Bad-Dog-Designs/Ospray-8/Syntom/Syntom.jpg

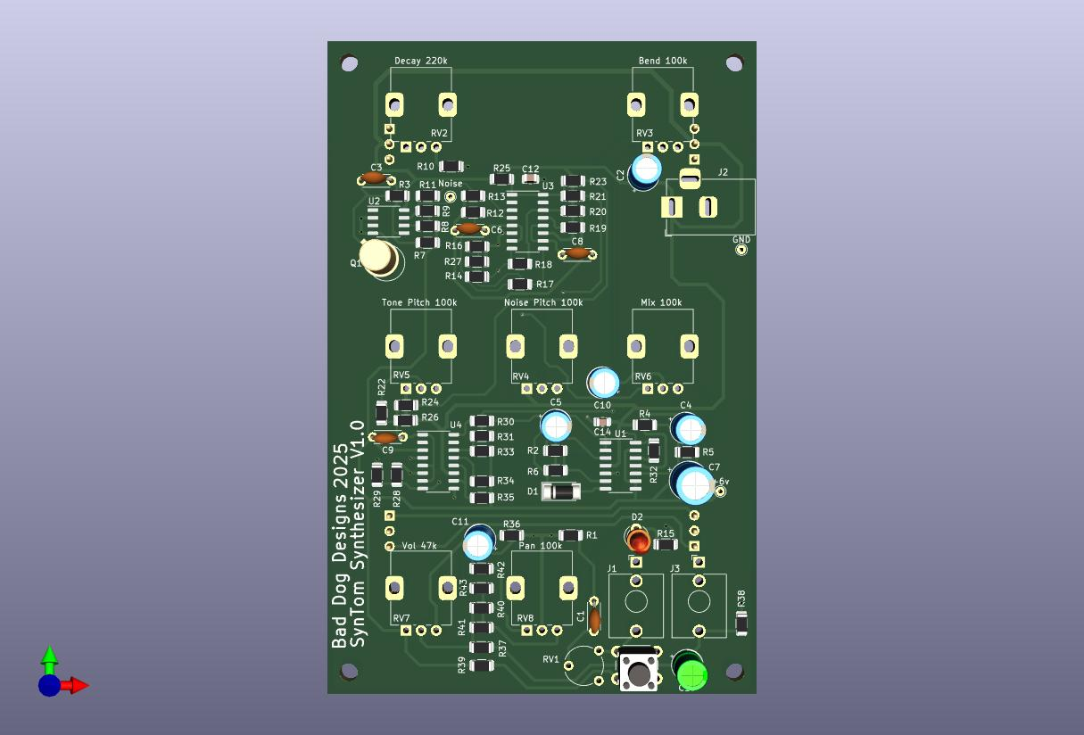
Syntom/Syntom.jpg
