Bad-Dog-Designs/Ospray-8/Front Panel/Side Panel MKII.pdf

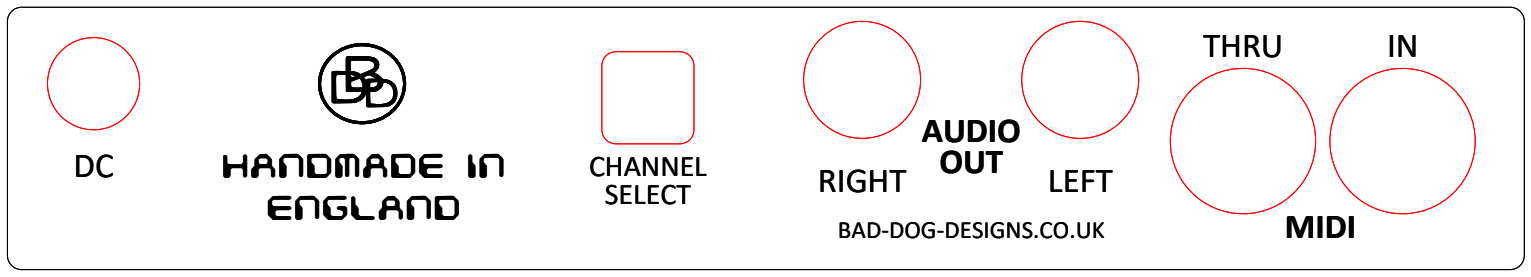
[picture p2: figure]
THRU; RIGHT; LEFT DC; CHANNEL; MIDI; AUDIO; SELECT; OUT; DBD; HANDMADE IN ENGLAND; BAD; -DOG; -DESIGNS.CO.UK
