Bad-Dog-Designs/Ospray-8/Front Panel/Ospray8_Final_front_panel.pdf

## OSPRAY

-8-

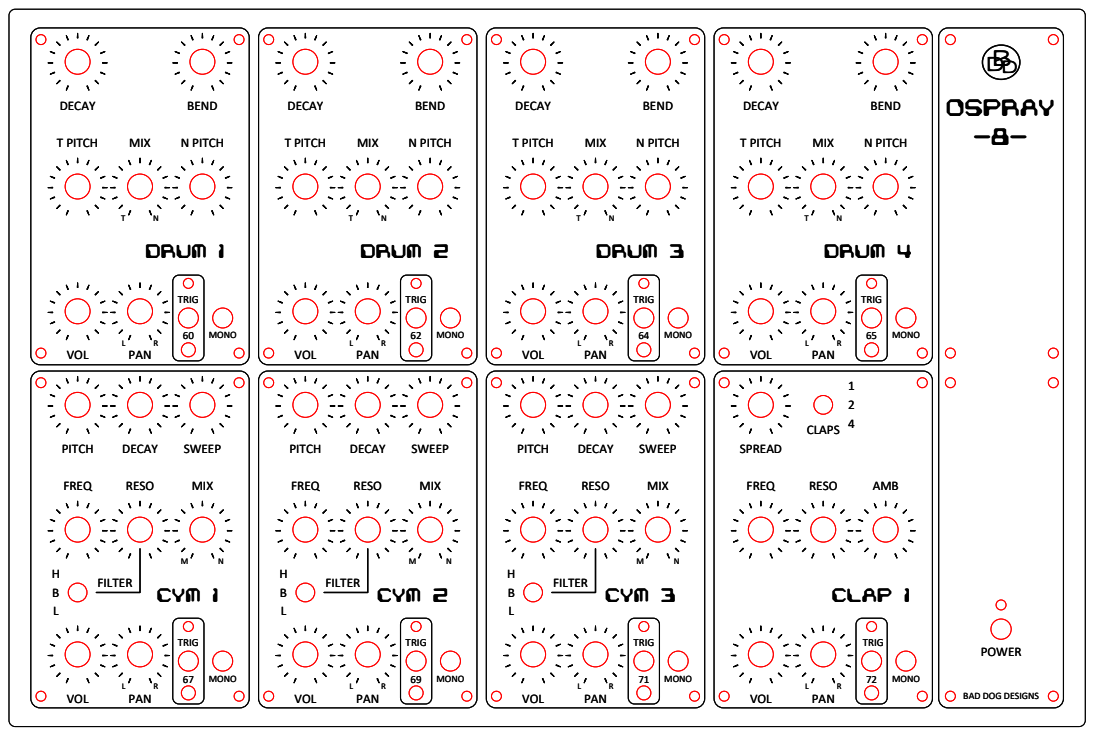
[picture p3: page 1]
PITCH; DECAY; SWEEP; VOL; BEND; FREQ; RESO; PAN; FILTER; T PITCH; MIX; N PITCH; SPREAD; AMB; CLAPS; TRIG; MONO; DRUM 1; DRUM 2; DRUM 3; DRUM 4; CYM 1; CYM 2; CYM 3; CLAP 1; POWER; DBD; OSPRAY -8-

BAD DOG DESIGNS
