Bad-Dog-Designs/Ospray-8/Synbal/Synbal.kicad_pcb

## KiCad design Synbal/Synbal.kicad_pcb (2026-06-27)

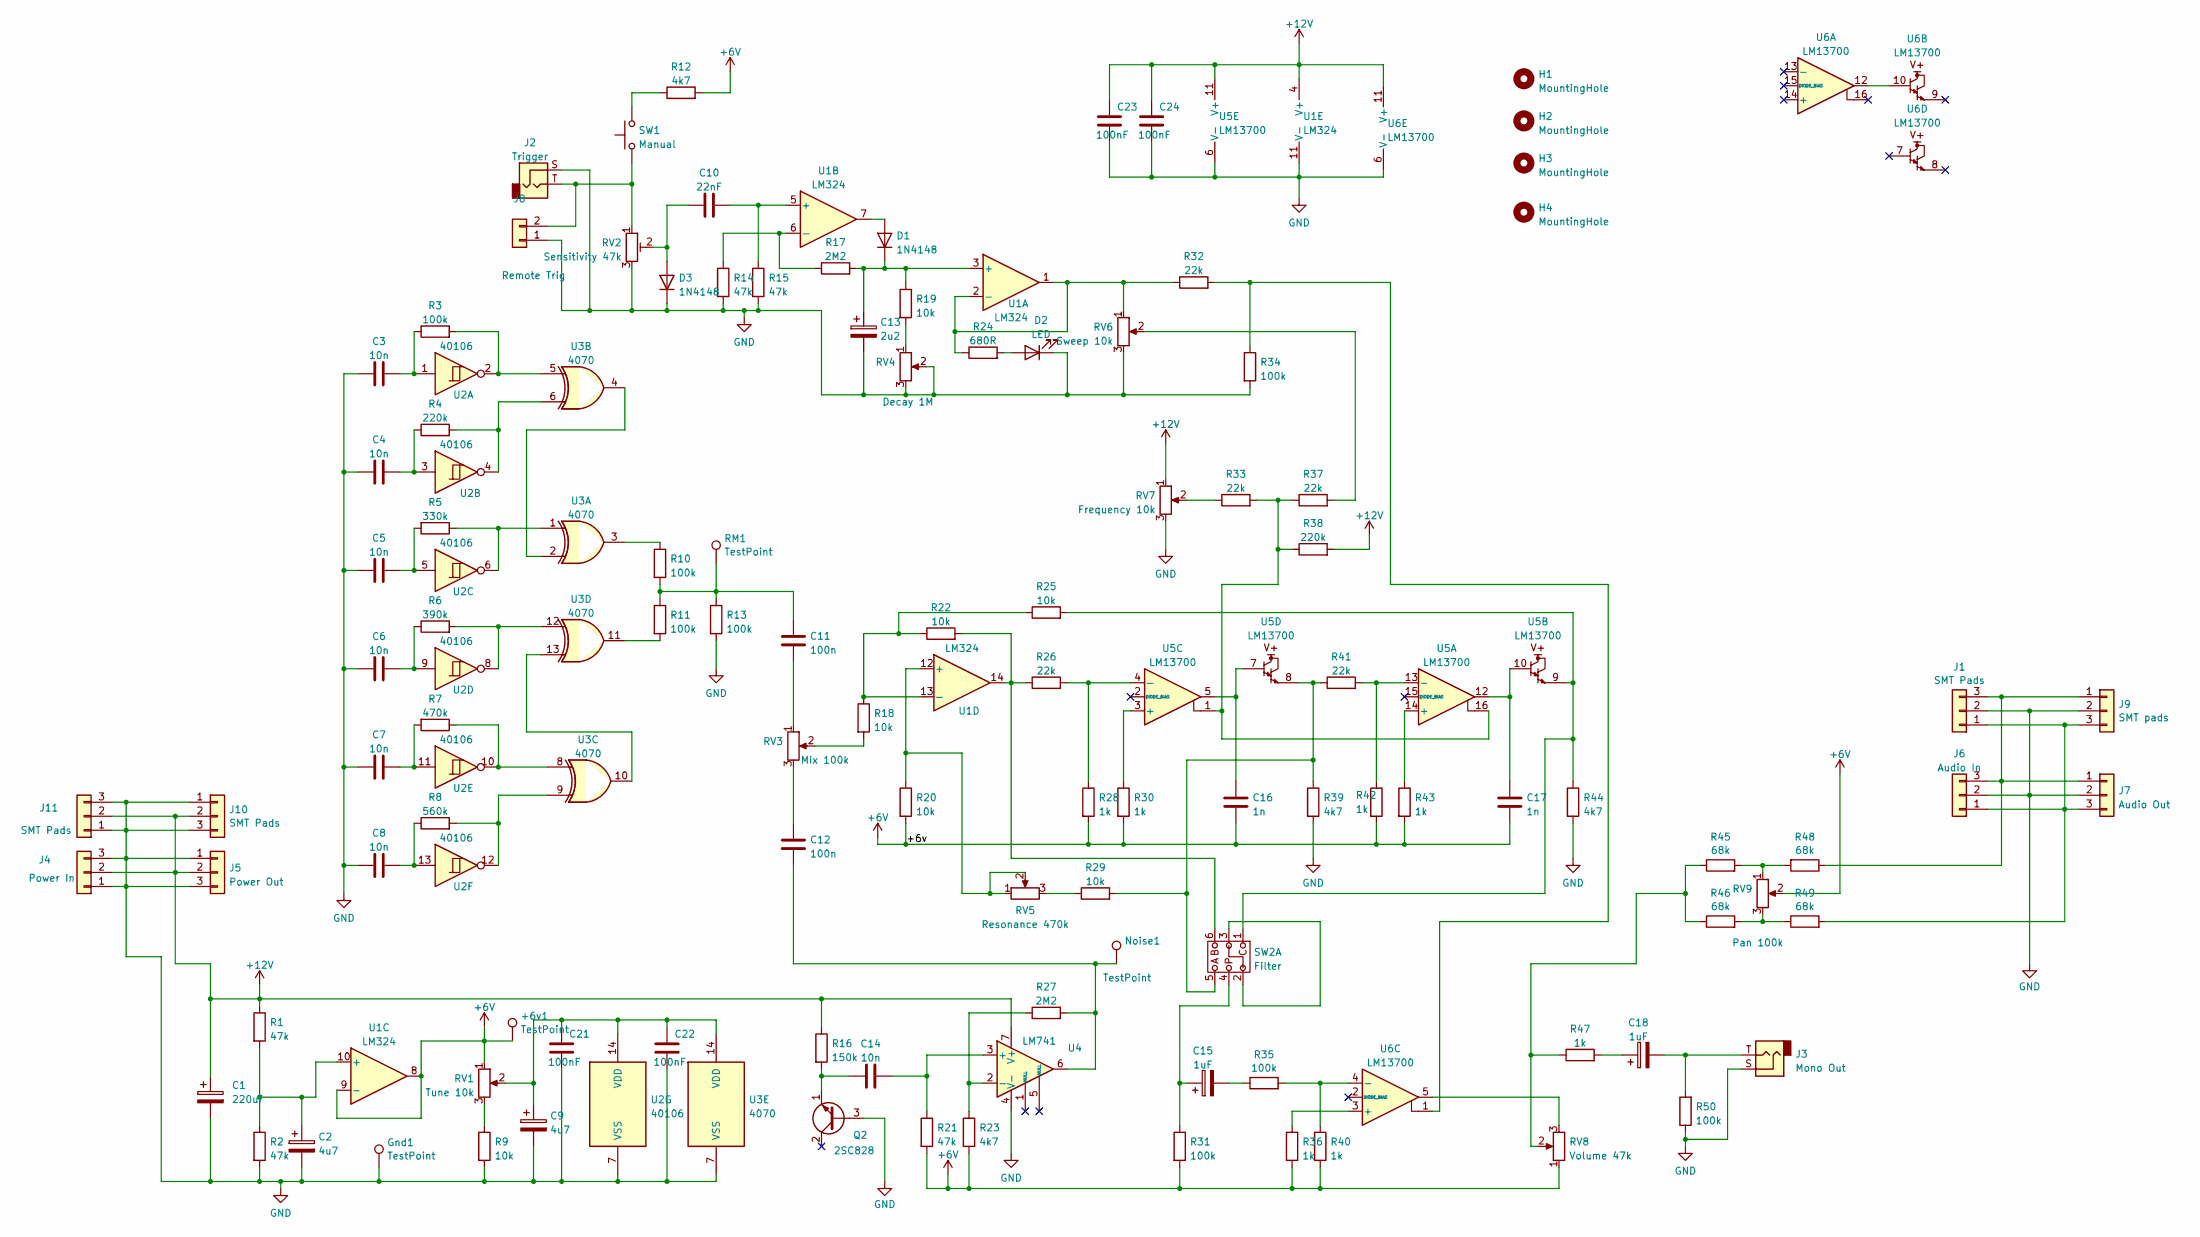
[picture p4: schematic Synbal.kicad_sch]

Parts:
+6v1: TestPoint; TestPoint_Keystone_5010-5014_Multipurpose
C1: 220uf; CP_Radial_D8.0mm_P3.50mm
C2, C9: 4u7; CP_Radial_D4.0mm_P1.50mm
C3, C4, C5, C6, C7, C8, C14: 10n; C_Disc_D7.0mm_W2.5mm_P5.00mm
C10: 22nF; C_Disc_D7.0mm_W2.5mm_P5.00mm
C11, C12: 100n; C_Disc_D7.0mm_W2.5mm_P5.00mm
C13: 2u2; CP_Radial_D4.0mm_P1.50mm
C15, C18: 1uF; CP_Radial_D4.0mm_P1.50mm
C16, C17: 1n; C_Disc_D7.0mm_W2.5mm_P5.00mm
C21, C22, C23, C24: 100nF; C_0805_2012Metric
D1, D3: 1N4148; D_MiniMELF
D2: LED; LED_D3.0mm
Gnd1: TestPoint; TestPoint_Keystone_5010-5014_Multipurpose
H1, H2, H3, H4: MountingHole; MountingHole_3.2mm_M3_ISO7380_Pad
J1, J10, J11: SMT Pads; Bus Connector
J2: Trigger; Jack_3.5mm_QingPu_WQP-PJ398SM_Vertical_CircularHoles
J3: Mono Out; Jack_3.5mm_QingPu_WQP-PJ398SM_Vertical_CircularHoles
J4: Power In; PinHeader_1x03_P2.54mm_Horizontal
J5: Power Out; PinHeader_1x03_P2.54mm_Horizontal
J6: Audio In; PinHeader_1x03_P2.54mm_Horizontal
J7: Audio Out; PinHeader_1x03_P2.54mm_Horizontal
J8: Remote Trig; PinHeader_1x02_P2.54mm_Vertical
J9: SMT pads; Bus Connector
Noise1: TestPoint; TestPoint_Keystone_5010-5014_Multipurpose
Q2: 2SC828; TO-92_Inline
R1, R2, R14, R15, R21: 47k; R_1206_3216Metric
R3, R10, R11, R13, R31, R34, R35, R50: 100k; R_1206_3216Metric
R4, R38: 220k; R_1206_3216Metric
R5: 330k; R_1206_3216Metric
R6: 390k; R_1206_3216Metric
R7: 470k; R_1206_3216Metric
R8: 560k; R_1206_3216Metric
R9, R18, R19, R20, R22, R25, R29: 10k; R_1206_3216Metric
R12, R23, R39, R44: 4k7; R_1206_3216Metric
R16: 150k; R_1206_3216Metric
R17, R27: 2M2; R_1206_3216Metric
R24: 680R; R_1206_3216Metric
R26, R32, R33, R37, R41: 22k; R_1206_3216Metric
R28, R30, R36, R40, R42, R43, R47: 1k; R_1206_3216Metric
R45, R46, R48, R49: 68k; R_1206_3216Metric
RM1: TestPoint; TestPoint_Keystone_5010-5014_Multipurpose
RV1: Tune 10k; Potentiometer_Alps_RK09K_Single_Vertical
RV2: Sensitivity 47k; Potentiometer_Piher_PT-6-V_Vertical
RV3: Mix 100k; Potentiometer_Alps_RK09K_Single_Vertical
RV4: Decay 1M; Potentiometer_Alps_RK09K_Single_Vertical
RV5: Resonance 470k; Potentiometer_Alps_RK09K_Single_Vertical
RV6: Sweep 10k; Potentiometer_Alps_RK09K_Single_Vertical
RV7: Frequency 10k; Potentiometer_Alps_RK09K_Single_Vertical
RV8: Volume 47k; Potentiometer_Alps_RK09K_Single_Vertical
RV9: Pan 100k; Potentiometer_Alps_RK09K_Single_Vertical
SW1: Manual; SW_PUSH_6mm_H5mm
SW2: Filter; 1P3WSW
U1: LM324; SOIC-14_3.9x8.7mm_P1.27mm
U2: 40106; SO-14_3.9x8.65mm_P1.27mm
U3: 4070; SO-14_3.9x8.65mm_P1.27mm
U4: LM741; SOIC-8_3.9x4.9mm_P1.27mm
U5, U6: LM13700; SOIC-16_3.9x9.9mm_P1.27mm

Connections:
+6V: +6v1.1, C16.2, C17.2, R12.2, R20.2, R21.2, R23.2, R28.2, R30.2, R31.2, R36.2, R40.2, R42.2, R43.2, RV1.1, RV8.1, RV9.2, U1.8, U1.9 (-); also elsewhere on the board
+12V: C1.1, C23.1, C24.1, J4.2, J5.2, J10.2, J11.2, R1.1, R16.1, R38.2, RV7.1, U1.4 (V+), U4.7 (V+), U5.11 (V+), U6.11 (V+)
GND: C1.2, C2.2, C3.1, C4.1, C5.1, C6.1, C7.1, C8.1, C9.2, C13.2, C21.2, C22.2, C23.2, C24.2, D2.1 (K), D3.1 (K), Gnd1.1, H1.1, H2.1, H3.1, H4.1, J1.2, J2.S, J3.S, J4.1, J4.3, J5.1, J5.3, J6.2, J7.2, J8.1, J9.2, J10.1, J10.3, J11.1, J11.3, Q2.3 (B), R2.2, R9.2, R13.2, R14.2, R15.2, R34.2, R39.2, R44.2, R50.1, RV1.MP, RV2.3, RV3.MP, RV4.2, RV4.3, RV4.MP, RV5.MP, RV6.3, RV6.MP, RV7.3, RV7.MP, RV8.MP, RV9.MP, U1.11 (V-), U2.7 (VSS), U3.7 (VSS), U4.4 (V-), U5.6 (V-), U6.6 (V-); also elsewhere on the board
unnamed: C3.2, R3.1, U2.1
unnamed: C4.2, R4.1, U2.3
unnamed: C5.2, R5.2, U2.5
unnamed: C6.2, R6.1, U2.9
unnamed: C7.2, R7.2, U2.11
unnamed: C8.2, R8.1, U2.13
unnamed 9: C11.1, R10.2, R11.1, R13.1, RM1.1; also elsewhere on the board
unnamed: C11.2, RV3.1
unnamed: C12.1, RV3.3
unnamed 12: C12.2, Noise1.1, R27.2, U4.6; also elsewhere on the board
unnamed: C15.1, R31.1, SW2.4
unnamed: C15.2, R35.1
unnamed: C16.1, U5.5, U5.7
unnamed: C17.1, U5.10, U5.12
unnamed: C18.1, R47.2
unnamed: C18.2, J3.T, R50.2
unnamed: D1.2 (A), U1.7
unnamed: C13.1, D1.1 (K), R17.2, R19.1, U1.3 (+)
unnamed: D2.2 (A), R24.2
unnamed: C10.1, D3.2 (A), RV2.2
unnamed: J1.1, J6.1, J7.3, J9.3, R49.2
unnamed: J1.3, J6.3, J7.1, J9.1, R48.1
unnamed: J2.T, J8.2, RV2.1, SW1.1
unnamed: C14.1, Q2.1 (E), R16.2
unnamed: R3.2, U2.2, U3.5
unnamed: R4.2, U2.4, U3.6
unnamed: R5.1, U2.6, U3.1
unnamed: R6.2, U2.8, U3.12
unnamed: R7.1, U2.10, U3.8
unnamed: R8.2, U2.12, U3.9
unnamed: R9.1, RV1.3
unnamed: R10.1, U3.3
unnamed: R11.2, U3.11
unnamed: R12.1, SW1.2
unnamed: R18.2, RV3.2
unnamed: R19.2, RV4.1
unnamed: R22.2, R26.1, SW2.6, U1.14
unnamed: R25.2, R44.1, SW2.1, U5.9
unnamed: R29.1, RV5.3
unnamed: R29.2, R39.1, R41.1, SW2.5, U5.8
unnamed: R32.2, R34.1, U6.1
unnamed: R33.1, RV7.2
unnamed: R33.2, R37.1, R38.1, U5.1, U5.16
unnamed: R37.2, RV6.2
unnamed: R45.1, R46.1, R47.1, RV8.2
unnamed: R45.2, R48.2, RV9.1
unnamed: R46.2, R49.1, RV9.3
unnamed: RV8.3, U6.5
unnamed: SW2.2, SW2.3
unnamed: R24.1, R32.1, RV6.1, U1.1, U1.2 (-)
unnamed: C10.2, R15.1, U1.5 (+)
unnamed: R14.1, R17.1, U1.6 (-)
unnamed: C2.1, R1.2, R2.1, U1.10 (+)
unnamed: R20.1, RV5.1, RV5.2, U1.12 (+)
unnamed: R18.1, R22.1, R25.1, U1.13 (-)
unnamed: C9.1, C21.1, C22.1, RV1.2, U2.14 (VDD), U3.14 (VDD)
unnamed: U3.2, U3.4
unnamed: U3.10, U3.13
unnamed: C14.2, R21.1, U4.3 (+)
unnamed: R23.1, R27.1, U4.2 (-)
unnamed: R43.1, U5.14 (+)
unnamed: R41.2, R42.1, U5.13 (-)
unnamed: R30.1, U5.3 (+)
unnamed: R26.2, R28.1, U5.4 (-)
unnamed: U6.10, U6.12
unnamed: R36.1, U6.3 (+)
unnamed: R35.2, R40.1, U6.4 (-)

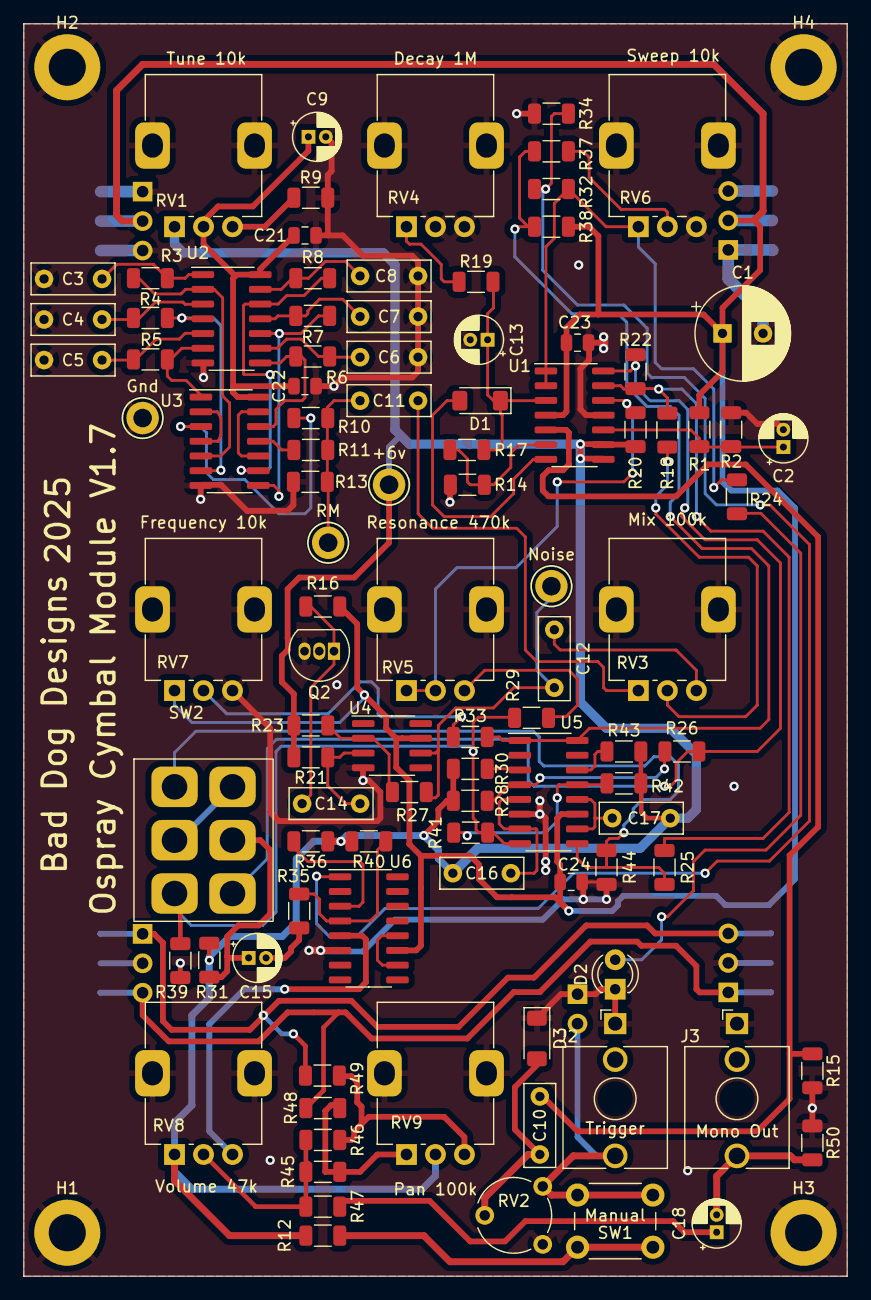
[picture p5: board Synbal.kicad_pcb from above]

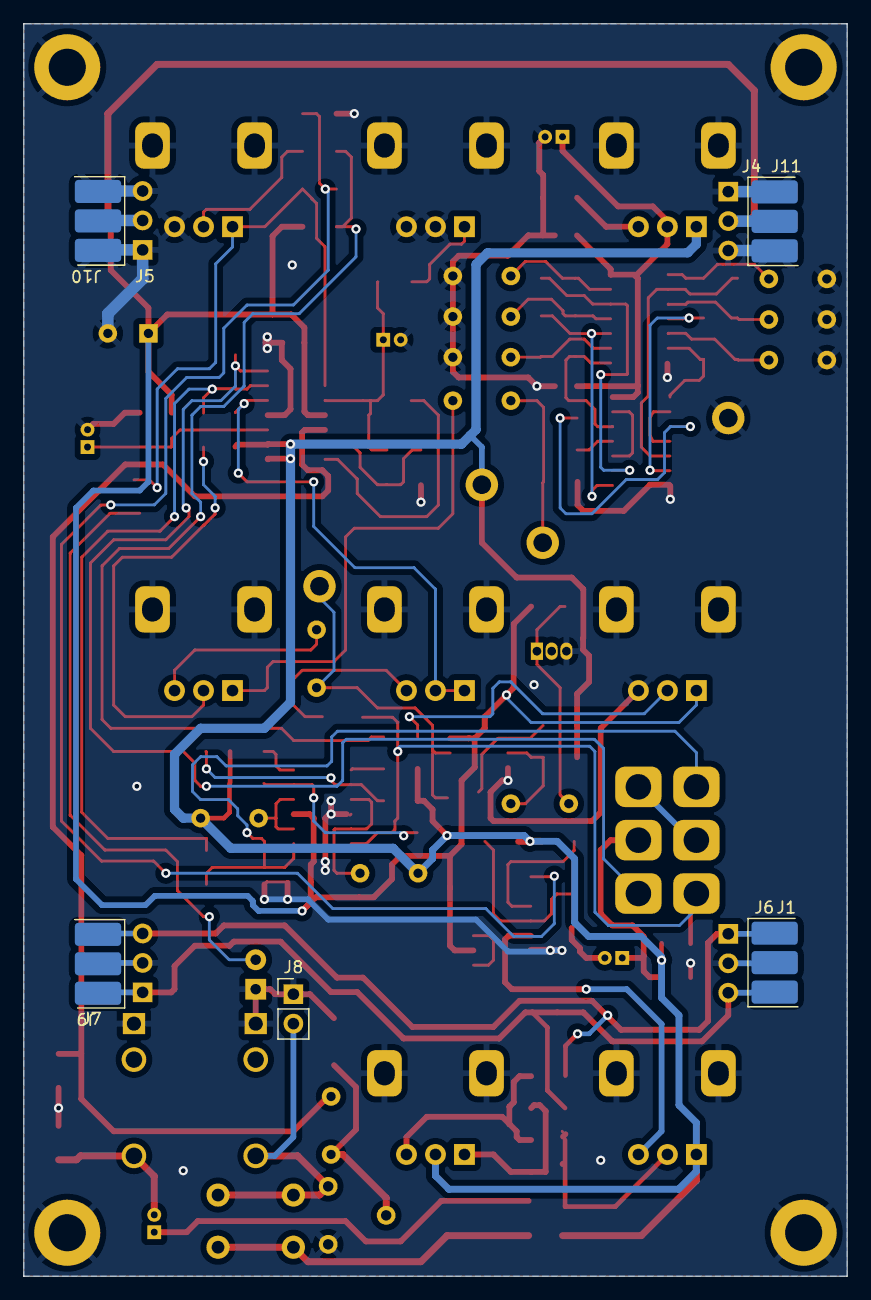
[picture p6: board Synbal.kicad_pcb from below]

Board: 2 copper layers, 71.0 x 108.0 mm, 112 parts (9 on the bottom side), 70 nets.

Other parts of the board:
+6v: TestPoint; TestPoint_Keystone_5010-5014_Multipurpose
Gnd: TestPoint; TestPoint_Keystone_5010-5014_Multipurpose
Noise: TestPoint; TestPoint_Keystone_5010-5014_Multipurpose
RM: TestPoint; TestPoint_Keystone_5010-5014_Multipurpose

Their connections:
+6V: +6v.1; also elsewhere on the board
GND: Gnd.1; also elsewhere on the board
unnamed 9: RM.1; also elsewhere on the board
unnamed 12: Noise.1; also elsewhere on the board
