Bad-Dog-Designs/Ospray-8/Syntom/Syntom.kicad_pcb

## KiCad design Syntom/Syntom.kicad_pcb (2026-06-27)

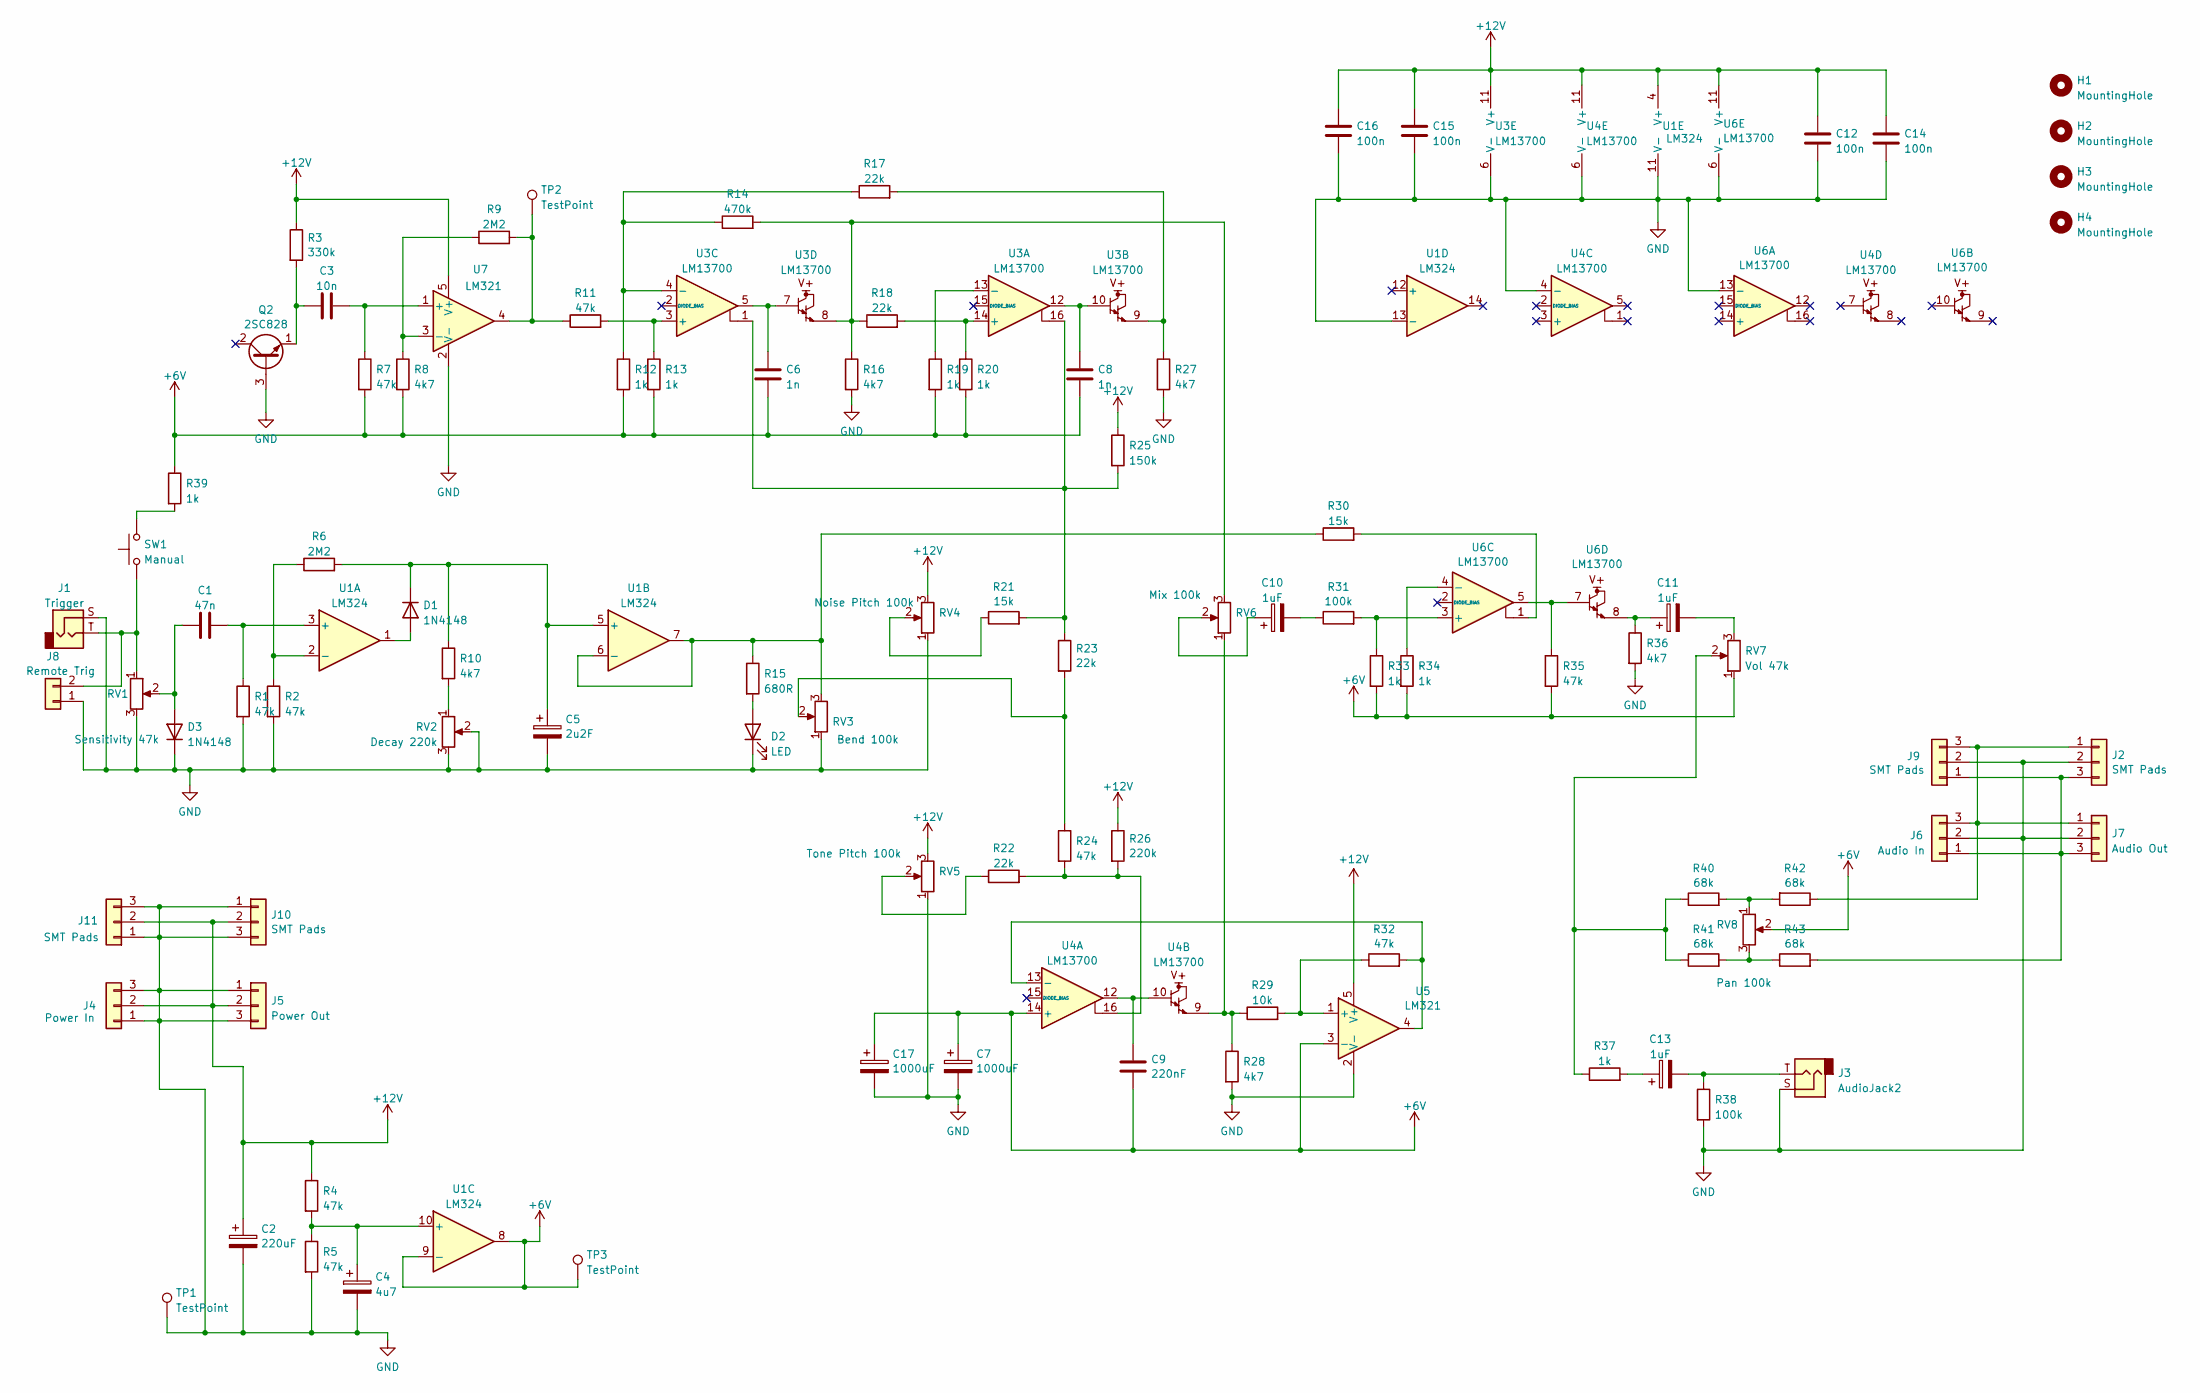
[picture p7: schematic Syntom.kicad_sch]

Parts:
C1: 47n; C_Disc_D4.3mm_W1.9mm_P5.00mm
C2: 220uF; CP_Radial_D8.0mm_P3.50mm
C3: 10n; C_Disc_D4.3mm_W1.9mm_P5.00mm
C4: 4u7; CP_Radial_D4.0mm_P1.50mm
C5: 2u2F; CP_Radial_D4.0mm_P1.50mm
C6, C8: 1n; C_Disc_D4.3mm_W1.9mm_P5.00mm
C7, C17: 1000uF; CP_Radial_D8.0mm_P3.50mm
C9: 220nF; C_Disc_D4.3mm_W1.9mm_P5.00mm
C10, C11, C13: 1uF; CP_Radial_D4.0mm_P1.50mm
C12, C14, C15, C16: 100n; C_0805_2012Metric
D1, D3: 1N4148; D_MiniMELF
D2: LED; LED_D3.0mm
H1, H2, H3, H4: MountingHole; MountingHole_3.2mm_M3_DIN965_Pad
J1: Trigger; Jack_3.5mm_QingPu_WQP-PJ398SM_Vertical_CircularHoles
J2, J9, J10, J11: SMT Pads; Bus Connector
J3: AudioJack2; Jack_3.5mm_QingPu_WQP-PJ398SM_Vertical_CircularHoles
J4: Power In; PinHeader_1x03_P2.54mm_Horizontal
J5: Power Out; PinHeader_1x03_P2.54mm_Horizontal
J6: Audio In; PinHeader_1x03_P2.54mm_Horizontal
J7: Audio Out; PinHeader_1x03_P2.54mm_Horizontal
J8: Remote Trig; PinHeader_1x02_P2.54mm_Vertical
Q2: 2SC828; TO-92_Inline
R1, R2, R4, R5, R7, R11, R24, R32, R35: 47k; R_1206_3216Metric
R3: 330k; R_1206_3216Metric
R6, R9: 2M2; R_1206_3216Metric
R8, R10, R16, R27, R28, R36: 4k7; R_1206_3216Metric
R12, R13, R19, R20, R33, R34, R37, R39: 1k; R_1206_3216Metric
R14: 470k; R_1206_3216Metric
R15: 680R; R_1206_3216Metric
R17, R18, R22, R23: 22k; R_1206_3216Metric
R21, R30: 15k; R_1206_3216Metric
R25: 150k; R_1206_3216Metric
R26: 220k; R_1206_3216Metric
R29: 10k; R_1206_3216Metric
R31, R38: 100k; R_1206_3216Metric
R40, R41, R42, R43: 68k; R_1206_3216Metric
RV1: Sensitivity 47k; Potentiometer_Piher_PT-6-V_Vertical
RV2: Decay 220k; Potentiometer_Alps_RK09K_Single_Vertical
RV3: Bend 100k; Potentiometer_Alps_RK09K_Single_Vertical
RV4: Noise Pitch 100k; Potentiometer_Alps_RK09K_Single_Vertical
RV5: Tone Pitch 100k; Potentiometer_Alps_RK09K_Single_Vertical
RV6: Mix 100k; Potentiometer_Alps_RK09K_Single_Vertical
RV7: Vol 47k; Potentiometer_Alps_RK09K_Single_Vertical
RV8: Pan 100k; Potentiometer_Alps_RK09K_Single_Vertical
SW1: Manual; SW_PUSH_6mm_H5mm
TP1, TP2, TP3: TestPoint; TestPoint_THTPad_D1.5mm_Drill0.7mm
U1: LM324; SO-14_3.9x8.65mm_P1.27mm
U3, U4, U6: LM13700; SO-16_3.9x9.9mm_P1.27mm
U5, U7: LM321; SOT-23-5

Connections:
+6V: C6.2, C7.1, C8.2, C9.2, C17.1, R7.2, R8.2, R12.2, R13.2, R19.2, R20.2, R33.2, R34.2, R35.2, R39.1, RV7.1, RV8.2, TP3.1, U1.8, U1.9 (-), U4.14 (+), U5.3 (-)
+12V: C2.1, C12.1, C14.1, C15.1, C16.1, J4.2, J5.2, J10.2, J11.2, R3.1, R4.1, R25.1, R26.1, RV4.3, RV5.3, U1.4 (V+), U3.11 (V+), U4.11 (V+), U5.5 (V+), U6.11 (V+), U7.5 (V+)
GND: C2.2, C4.2, C5.2, C7.2, C12.2, C14.2, C15.2, C16.2, C17.2, D2.1 (K), D3.1 (K), H1.1, H2.1, H3.1, H4.1, J1.S, J2.2, J3.S, J4.1, J4.3, J5.1, J5.3, J6.2, J7.2, J8.1, J9.2, J10.1, J10.3, J11.1, J11.3, Q2.3 (B), R1.2, R2.2, R5.2, R16.2, R27.2, R28.2, R36.2, R38.2, RV1.3, RV2.2, RV2.3, RV2.MP, RV3.1, RV3.MP, RV4.1, RV4.MP, RV5.1, RV5.MP, RV6.MP, RV7.MP, RV8.MP, TP1.1, U1.11 (V-), U1.13 (-), U3.6 (V-), U4.4 (-), U4.6 (V-), U5.2 (V-), U6.6 (V-), U6.13 (-), U7.2 (V-)
unnamed: C6.1, U3.5, U3.7
unnamed: C8.1, U3.10, U3.12
unnamed: C9.1, U4.10, U4.12
unnamed: C10.1, RV6.2
unnamed: C10.2, R31.1
unnamed: C11.1, R36.1, U6.8
unnamed: C11.2, RV7.3
unnamed: C13.1, R37.2
unnamed: C13.2, J3.T, R38.1
unnamed: D1.2 (A), U1.1
unnamed: C5.1, D1.1 (K), R6.2, R10.1, U1.5 (+)
unnamed: D2.2 (A), R15.2
unnamed: C1.1, D3.2 (A), RV1.2
unnamed: J2.1, J6.3, J7.1, J9.3, R42.1
unnamed: J2.3, J6.1, J7.3, J9.1, R43.2
unnamed: J1.T, J8.2, RV1.1, SW1.1
unnamed: C3.1, Q2.1 (E), R3.2
unnamed: R10.2, RV2.1
unnamed: R9.2, R11.1, TP2.1, U7.4
unnamed: R14.2, R16.1, R18.1, RV6.3, U3.8
unnamed: R17.2, R27.1, U3.9
unnamed: R21.1, RV4.2
unnamed: R21.2, R23.1, R25.2, U3.1, U3.16
unnamed: R22.1, RV5.2
unnamed: R22.2, R24.2, R26.2, U4.16
unnamed: R23.2, R24.1, RV3.2
unnamed: R28.1, R29.1, RV6.1, U4.9
unnamed: R30.2, U6.1
unnamed: R35.1, U6.5, U6.7
unnamed: R37.1, R40.1, R41.1, RV7.2
unnamed: R39.2, SW1.2
unnamed: R40.2, R42.2, RV8.1
unnamed: R41.2, R43.1, RV8.3
unnamed: C1.2, R1.1, U1.3 (+)
unnamed: R2.1, R6.1, U1.2 (-)
unnamed: R15.1, R30.1, RV3.3, U1.6 (-), U1.7
unnamed: C4.1, R4.2, R5.1, U1.10 (+)
unnamed: R18.2, R20.1, U3.14 (+)
unnamed: R19.1, U3.13 (-)
unnamed: R11.2, R13.1, U3.3 (+)
unnamed: R12.1, R14.1, R17.1, U3.4 (-)
unnamed: R32.2, U4.13 (-), U5.4
unnamed: R29.2, R32.1, U5.1 (+)
unnamed: R31.2, R33.1, U6.3 (+)
unnamed: R34.1, U6.4 (-)
unnamed: C3.2, R7.1, U7.1 (+)
unnamed: R8.1, R9.1, U7.3 (-)

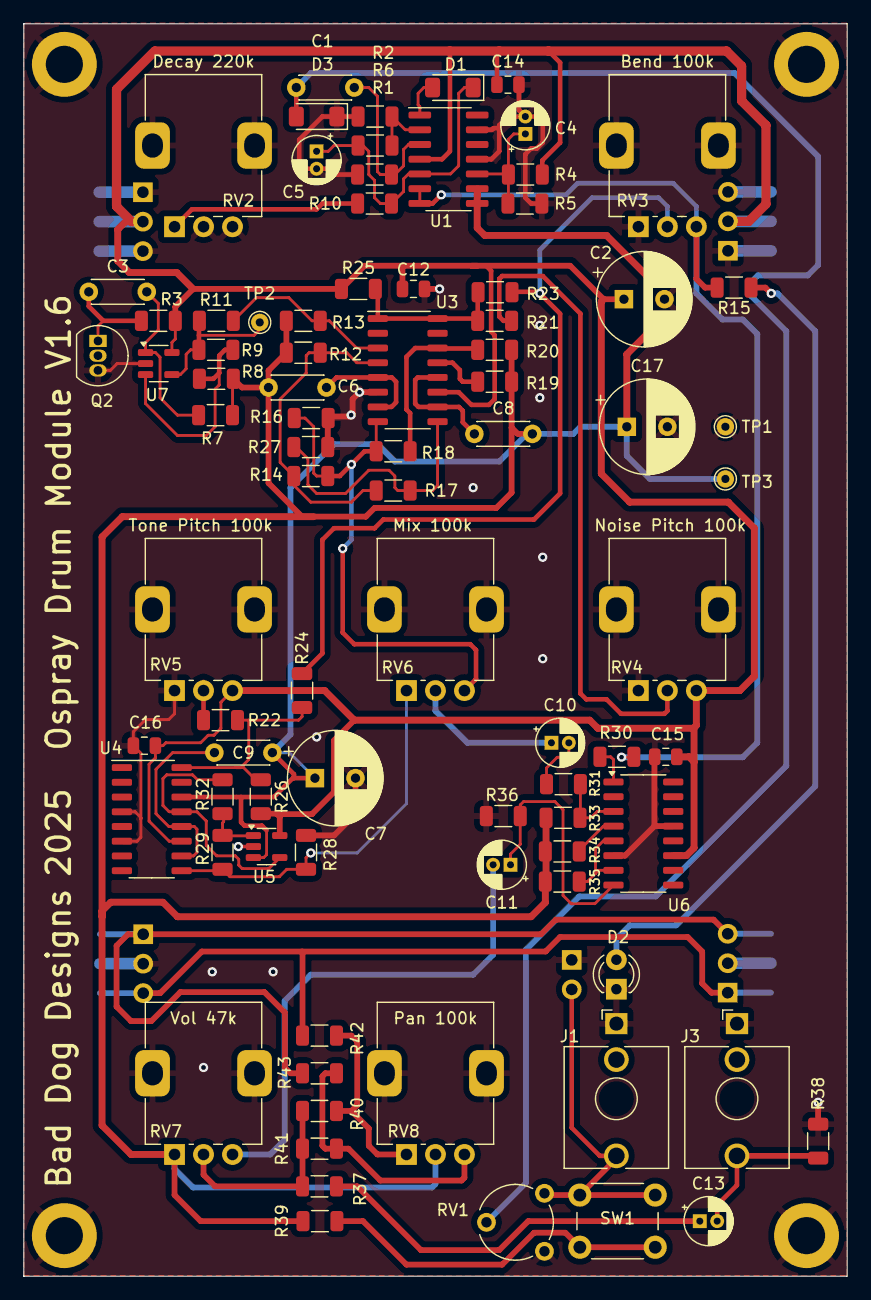
[picture p8: board Syntom.kicad_pcb from above]

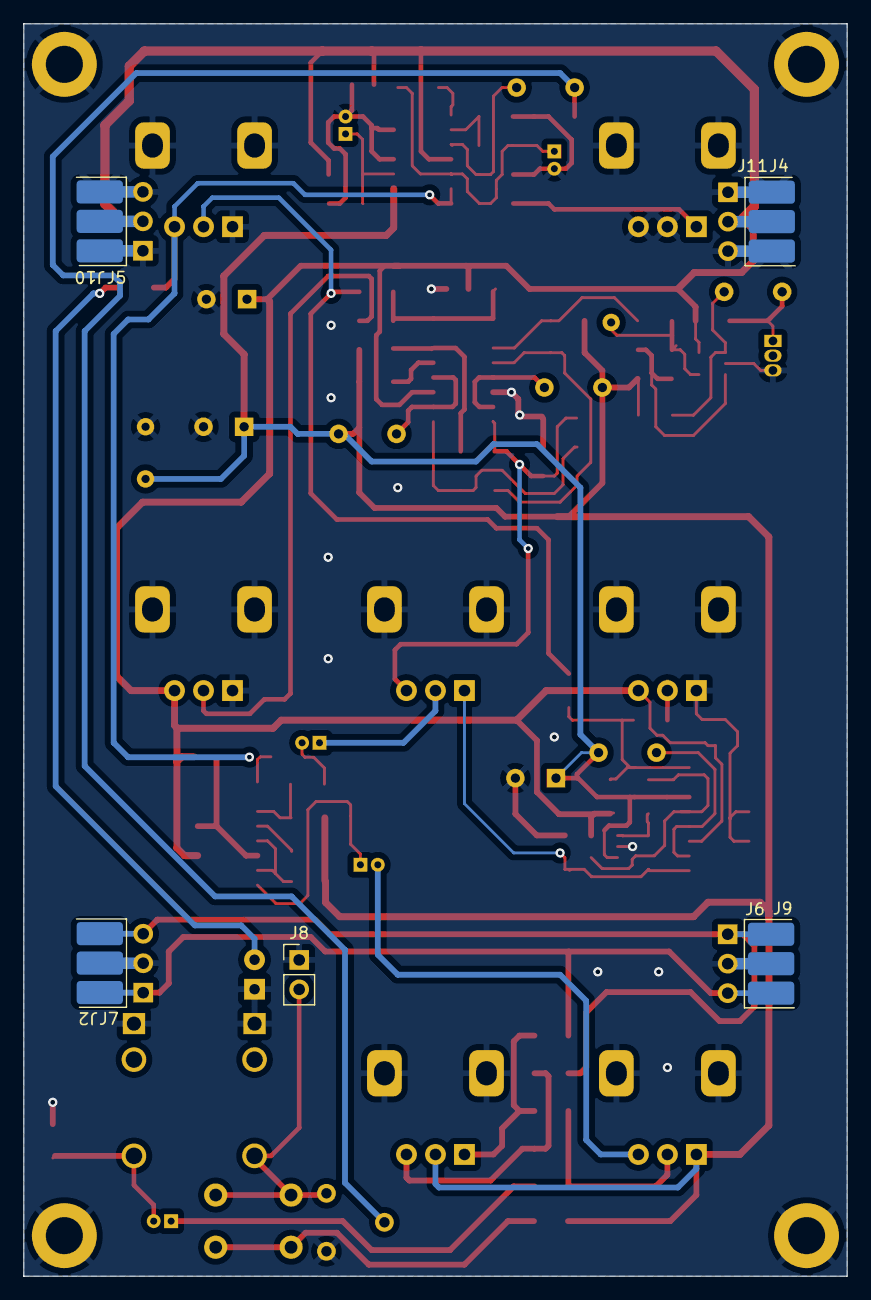
[picture p9: board Syntom.kicad_pcb from below]

Board: 2 copper layers, 71.0 x 108.0 mm, 97 parts (9 on the bottom side), 50 nets.
