Bad-Dog-Designs/Ospray-8/Synmidi/Synmidi.kicad_pcb

## KiCad design Synmidi/Synmidi.kicad_pcb (2026-06-27)

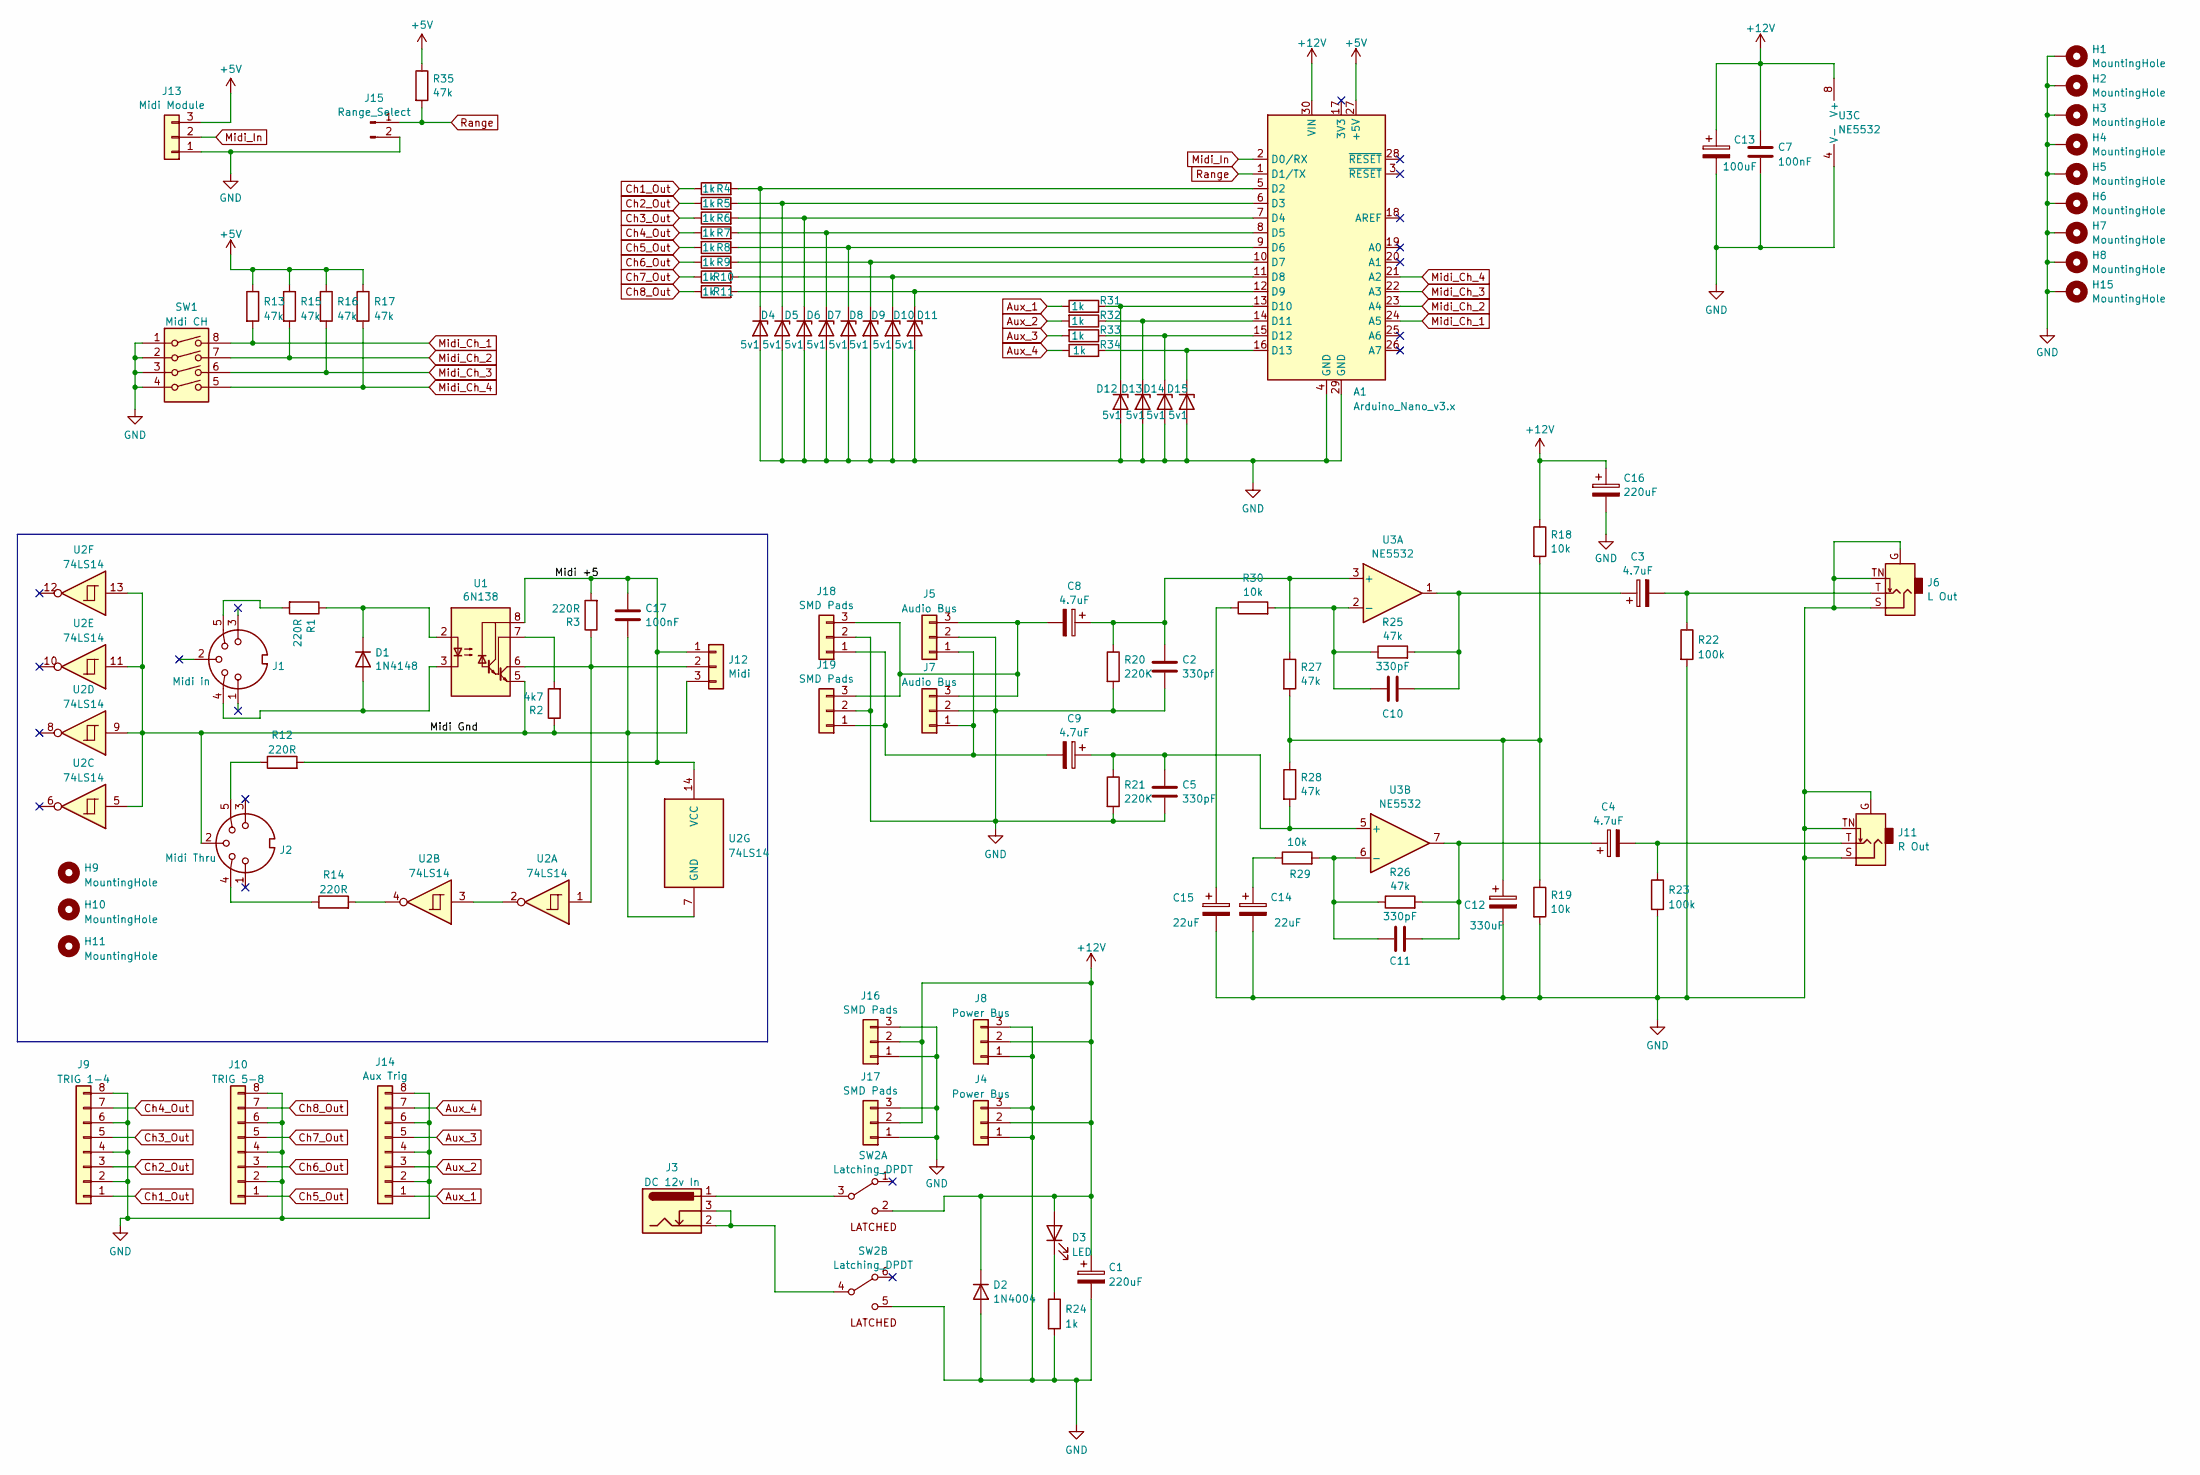
[picture p10: schematic Synmidi.kicad_sch]

Parts:
A1: Arduino_Nano_v3.x; Arduino_Nano
C1, C16: 220uF; CP_Radial_D10.0mm_P5.00mm
C2: 330pf; C_Disc_D4.3mm_W1.9mm_P5.00mm
C3, C4, C8, C9: 4.7uF; CP_Radial_D4.0mm_P1.50mm
C5, C10, C11: 330pF; C_Disc_D4.3mm_W1.9mm_P5.00mm
C7, C17: 100nF; C_0805_2012Metric
C12: 330uF; CP_Radial_D10.0mm_P5.00mm
C13: 100uF; CP_Radial_D8.0mm_P3.50mm
C14, C15: 22uF; CP_Radial_D5.0mm_P2.00mm
D1: 1N4148; D_MELF
D2: 1N4004; D_DO-41_SOD81_P10.16mm_Horizontal
D3: LED; LED_D3.0mm_FlatTop
D4, D5, D6, D7, D8, D9, D10, D11, D12, D13, D14, D15: 5v1; D_SOD-323
H1, H2, H3, H4, H5, H6, H7, H8, H9, H10, H11, H15: MountingHole; MountingHole_3.2mm_M3_DIN965_Pad
J1: Midi in; Midi_Socket
J2: Midi Thru; Midi_Socket
J3: DC 12v In; BarrelJack_GCT_DCJ200-10-A_Horizontal
J4, J8: Power Bus; PinHeader_1x03_P2.54mm_Horizontal
J5, J7: Audio Bus; PinHeader_1x03_P2.54mm_Horizontal
J6: L Out; 6.35mm_Socket_Mono
J9: TRIG 1-4; JST_EH_S8B-EH_1x08_P2.50mm_Horizontal
J10: TRIG 5-8; JST_EH_S8B-EH_1x08_P2.50mm_Horizontal
J11: R Out; 6.35mm_Socket_Mono
J12: Midi; PinHeader_1x03_P2.54mm_Vertical
J13: Midi Module; PinHeader_1x03_P2.54mm_Vertical
J14: Aux Trig; JST_EH_S8B-EH_1x08_P2.50mm_Horizontal
J15: Range_Select; PinHeader_1x02_P2.54mm_Vertical
J16, J17, J18, J19: SMD Pads; Bus Connector
R1, R3, R12, R14: 220R; R_1206_3216Metric
R2: 4k7; R_1206_3216Metric
R4, R5, R6, R7, R8, R9, R10, R11, R24, R31, R32, R33, R34: 1k; R_1206_3216Metric
R13, R15, R16, R17, R25, R26, R27, R28, R35: 47k; R_1206_3216Metric
R18, R19, R29, R30: 10k; R_1206_3216Metric
R20, R21: 220K; R_1206_3216Metric
R22, R23: 100k; R_1206_3216Metric
SW1: Midi CH; SW_DIP_SPSTx04_Piano_CTS_Series194-4MSTN_W7.62mm_P2.54mm
SW2: Latching_DPDT
U1: 6N138; DIP-8_W8.89mm_SMDSocket_LongPads
U2: 74LS14; SO-14_3.9x8.65mm_P1.27mm
U3: NE5532; SOIC-8_3.9x4.9mm_P1.27mm

Connections:
+5V: A1.27 (+5V), J13.3, R13.1, R15.1, R16.1, R17.1, R35.1
+12V: A1.30 (VIN), C1.1, C7.1, C13.1, C16.1, D2.1 (K), D3.2 (A), J4.2, J8.2, J16.2, J17.2, R18.1, SW2.2 (B), U3.8 (V+)
/Midi +5: C17.1, J12.1, R3.2, R12.2, U1.8 (VCC), U2.14 (VCC)
/Midi Gnd: C17.2, J2.2, J12.3, R2.1, U1.5 (GND), U2.5, U2.7 (GND), U2.9, U2.11, U2.13
Aux_1: J14.1, R31.1
Aux_2: J14.3, R32.2
Aux_3: J14.5, R33.2
Aux_4: J14.7, R34.1
Ch1_Out: J9.1, R4.1
Ch2_Out: J9.3, R5.1
Ch3_Out: J9.5, R6.1
Ch4_Out: J9.7, R7.1
Ch5_Out: J10.1, R8.2
Ch6_Out: J10.3, R9.1
Ch7_Out: J10.5, R10.1
Ch8_Out: J10.7, R11.1
GND: A1.4 (GND), A1.29 (GND), C1.2, C2.2, C5.2, C7.2, C12.2, C13.2, C14.2, C15.2, C16.2, D2.2 (A), D4.2 (A), D5.2 (A), D6.2 (A), D7.2 (A), D8.2 (A), D9.2 (A), D10.2 (A), D11.2 (A), D12.2 (A), D13.2 (A), D14.2 (A), D15.2 (A), H1.1, H2.1, H3.1, H4.1, H5.1, H6.1, H7.1, H8.1, H15.1, J4.1, J4.3, J5.2, J6.G, J6.S, J6.TN, J7.2, J8.1, J8.3, J9.2, J9.4, J9.6, J9.8, J10.2, J10.4, J10.6, J10.8, J11.G, J11.S, J11.TN, J13.1, J14.2, J14.4, J14.6, J14.8, J15.2, J16.1, J16.3, J17.1, J17.3, J18.2, J19.2, R19.2, R20.2, R21.2, R22.2, R23.2, R24.2, SW1.1, SW1.2, SW1.3, SW1.4, SW2.5 (B), U3.4 (V-)
Midi_Ch_1: A1.24 (A5), R13.2, SW1.8
Midi_Ch_2: A1.23 (A4), R15.2, SW1.7
Midi_Ch_3: A1.22 (A3), R16.2, SW1.6
Midi_Ch_4: A1.21 (A2), R17.2, SW1.5
Midi_In: A1.2 (D0/RX), J13.2
unnamed: A1.5 (D2), D4.1 (K), R4.2
unnamed: A1.6 (D3), D5.1 (K), R5.2
unnamed: A1.7 (D4), D6.1 (K), R6.2
unnamed: A1.8 (D5), D7.1 (K), R7.2
unnamed: A1.9 (D6), D8.1 (K), R8.1
unnamed: A1.10 (D7), D9.1 (K), R9.2
unnamed: A1.11 (D8), D10.1 (K), R10.2
unnamed: A1.12 (D9), D11.1 (K), R11.2
unnamed: A1.13 (D10), D12.1 (K), R31.2
unnamed: A1.14 (D11), D13.1 (K), R32.1
unnamed: A1.15 (D12), D14.1 (K), R33.1
unnamed: A1.16 (D13), D15.1 (K), R34.2
unnamed: C3.2, J6.T, R22.1
unnamed: C4.2, J11.T, R23.1
unnamed: C3.1, C10.2, R25.2, U3.1
unnamed: C4.1, C11.2, R26.2, U3.7
unnamed: C12.1, R18.2, R19.1, R27.2, R28.1
unnamed: C14.1, R29.1
unnamed: C15.1, R30.1
unnamed: D1.2 (A), J1.4, U1.3 (C2)
unnamed: D1.1 (K), R1.1, U1.2 (C1)
unnamed: D3.1 (K), R24.1
unnamed: J1.5, R1.2
unnamed: J2.4, R14.1
unnamed: J2.5, R12.1
unnamed: J12.2, R3.1, U1.6 (VO2), U2.1
unnamed: C9.2, J5.1, J7.1, J18.1, J19.1
unnamed: C8.2, J5.3, J7.3, J18.3, J19.3
unnamed: R14.2, U2.4
unnamed: J3.1, SW2.3 (C)
unnamed: J3.2, J3.3, SW2.4 (A)
unnamed: R2.2, U1.7 (VO1)
unnamed: U2.2, U2.3
unnamed: C2.1, C8.1, R20.1, R27.1, U3.3 (+)
unnamed: C10.1, R25.1, R30.2, U3.2 (-)
unnamed: C5.1, C9.1, R21.1, R28.2, U3.5 (+)
unnamed: C11.1, R26.1, R29.2, U3.6 (-)
Range: A1.1 (D1/TX), J15.1, R35.2
