Bad-Dog-Designs/Ospray-8/Synmidi/Synmidi.kicad_pcb

## KiCad design Synmidi/Synmidi.kicad_pcb (continued)

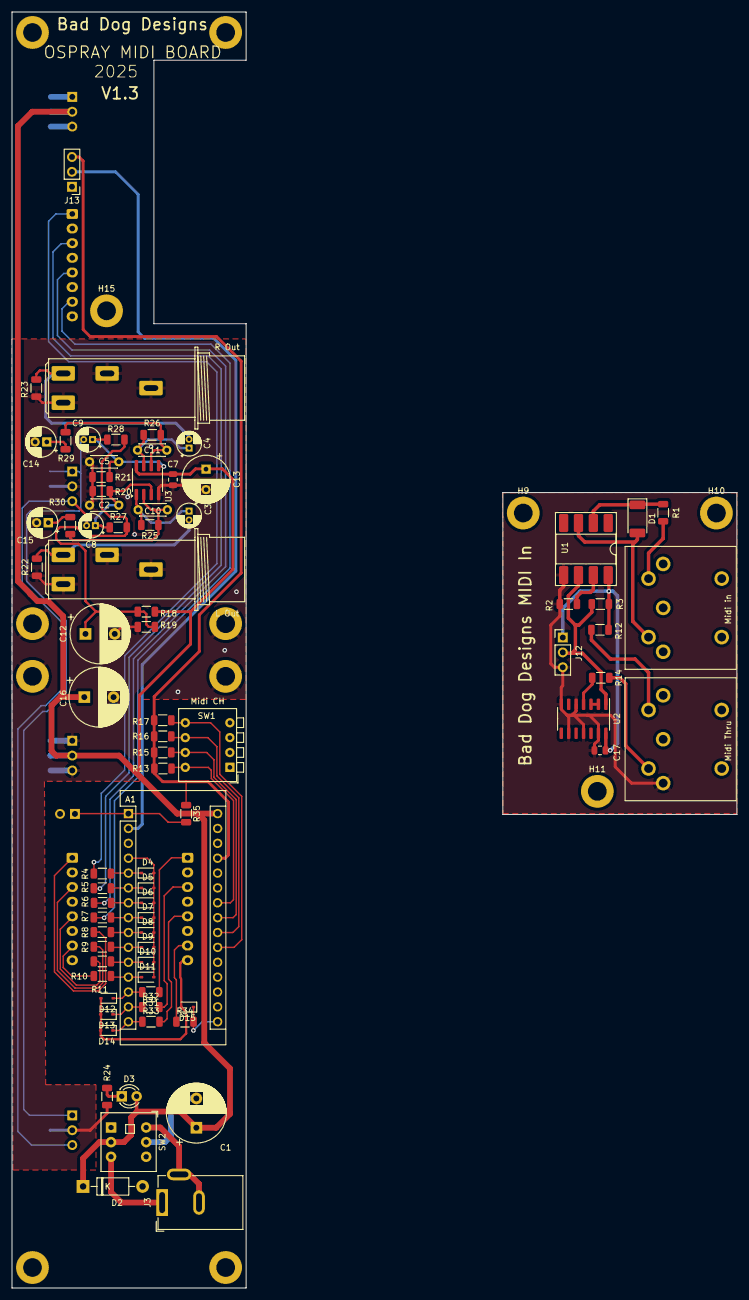
[picture p11: board Synmidi.kicad_pcb from above]

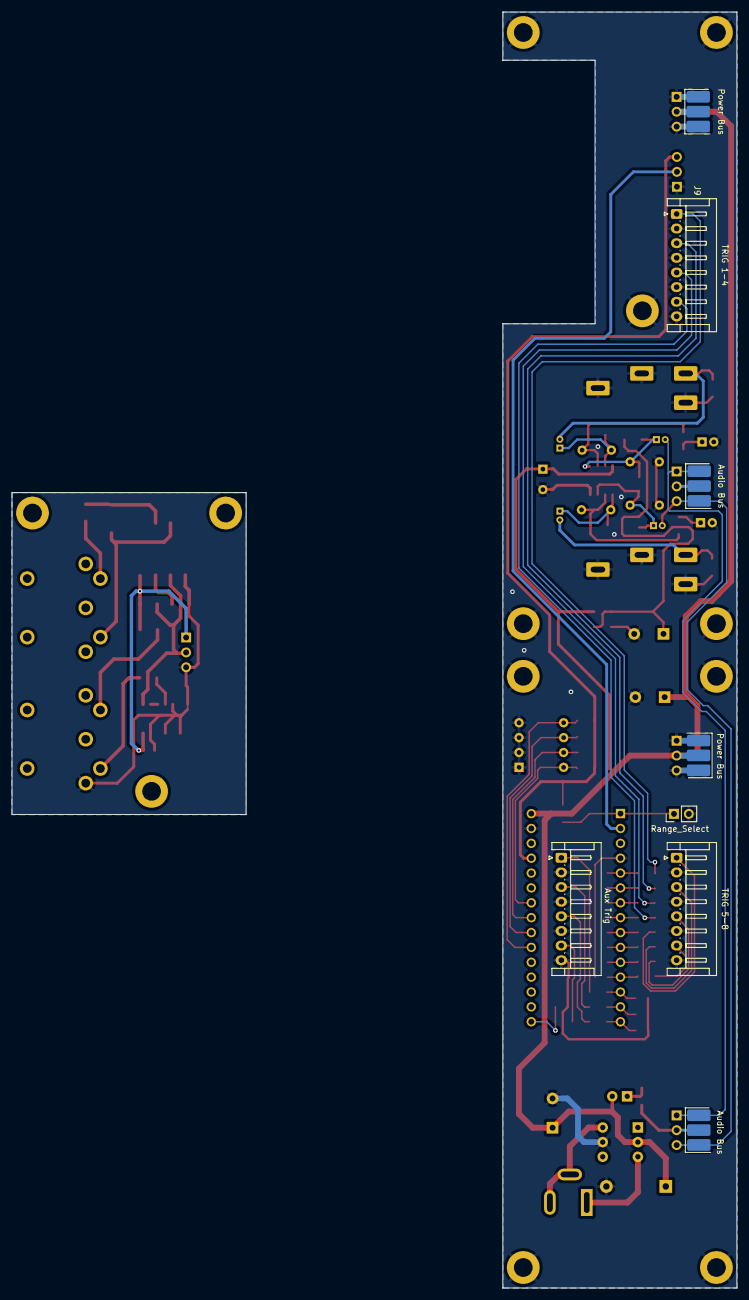
[picture p12: board Synmidi.kicad_pcb from below]

Board: 2 copper layers, 40.0 x 218.0 mm, 103 parts (12 on the bottom side), 60 nets.
