Bad-Dog-Designs/Ospray-8/Synclap/Synclap.kicad_pcb

## KiCad design Synclap/Synclap.kicad_pcb (2026-06-27)

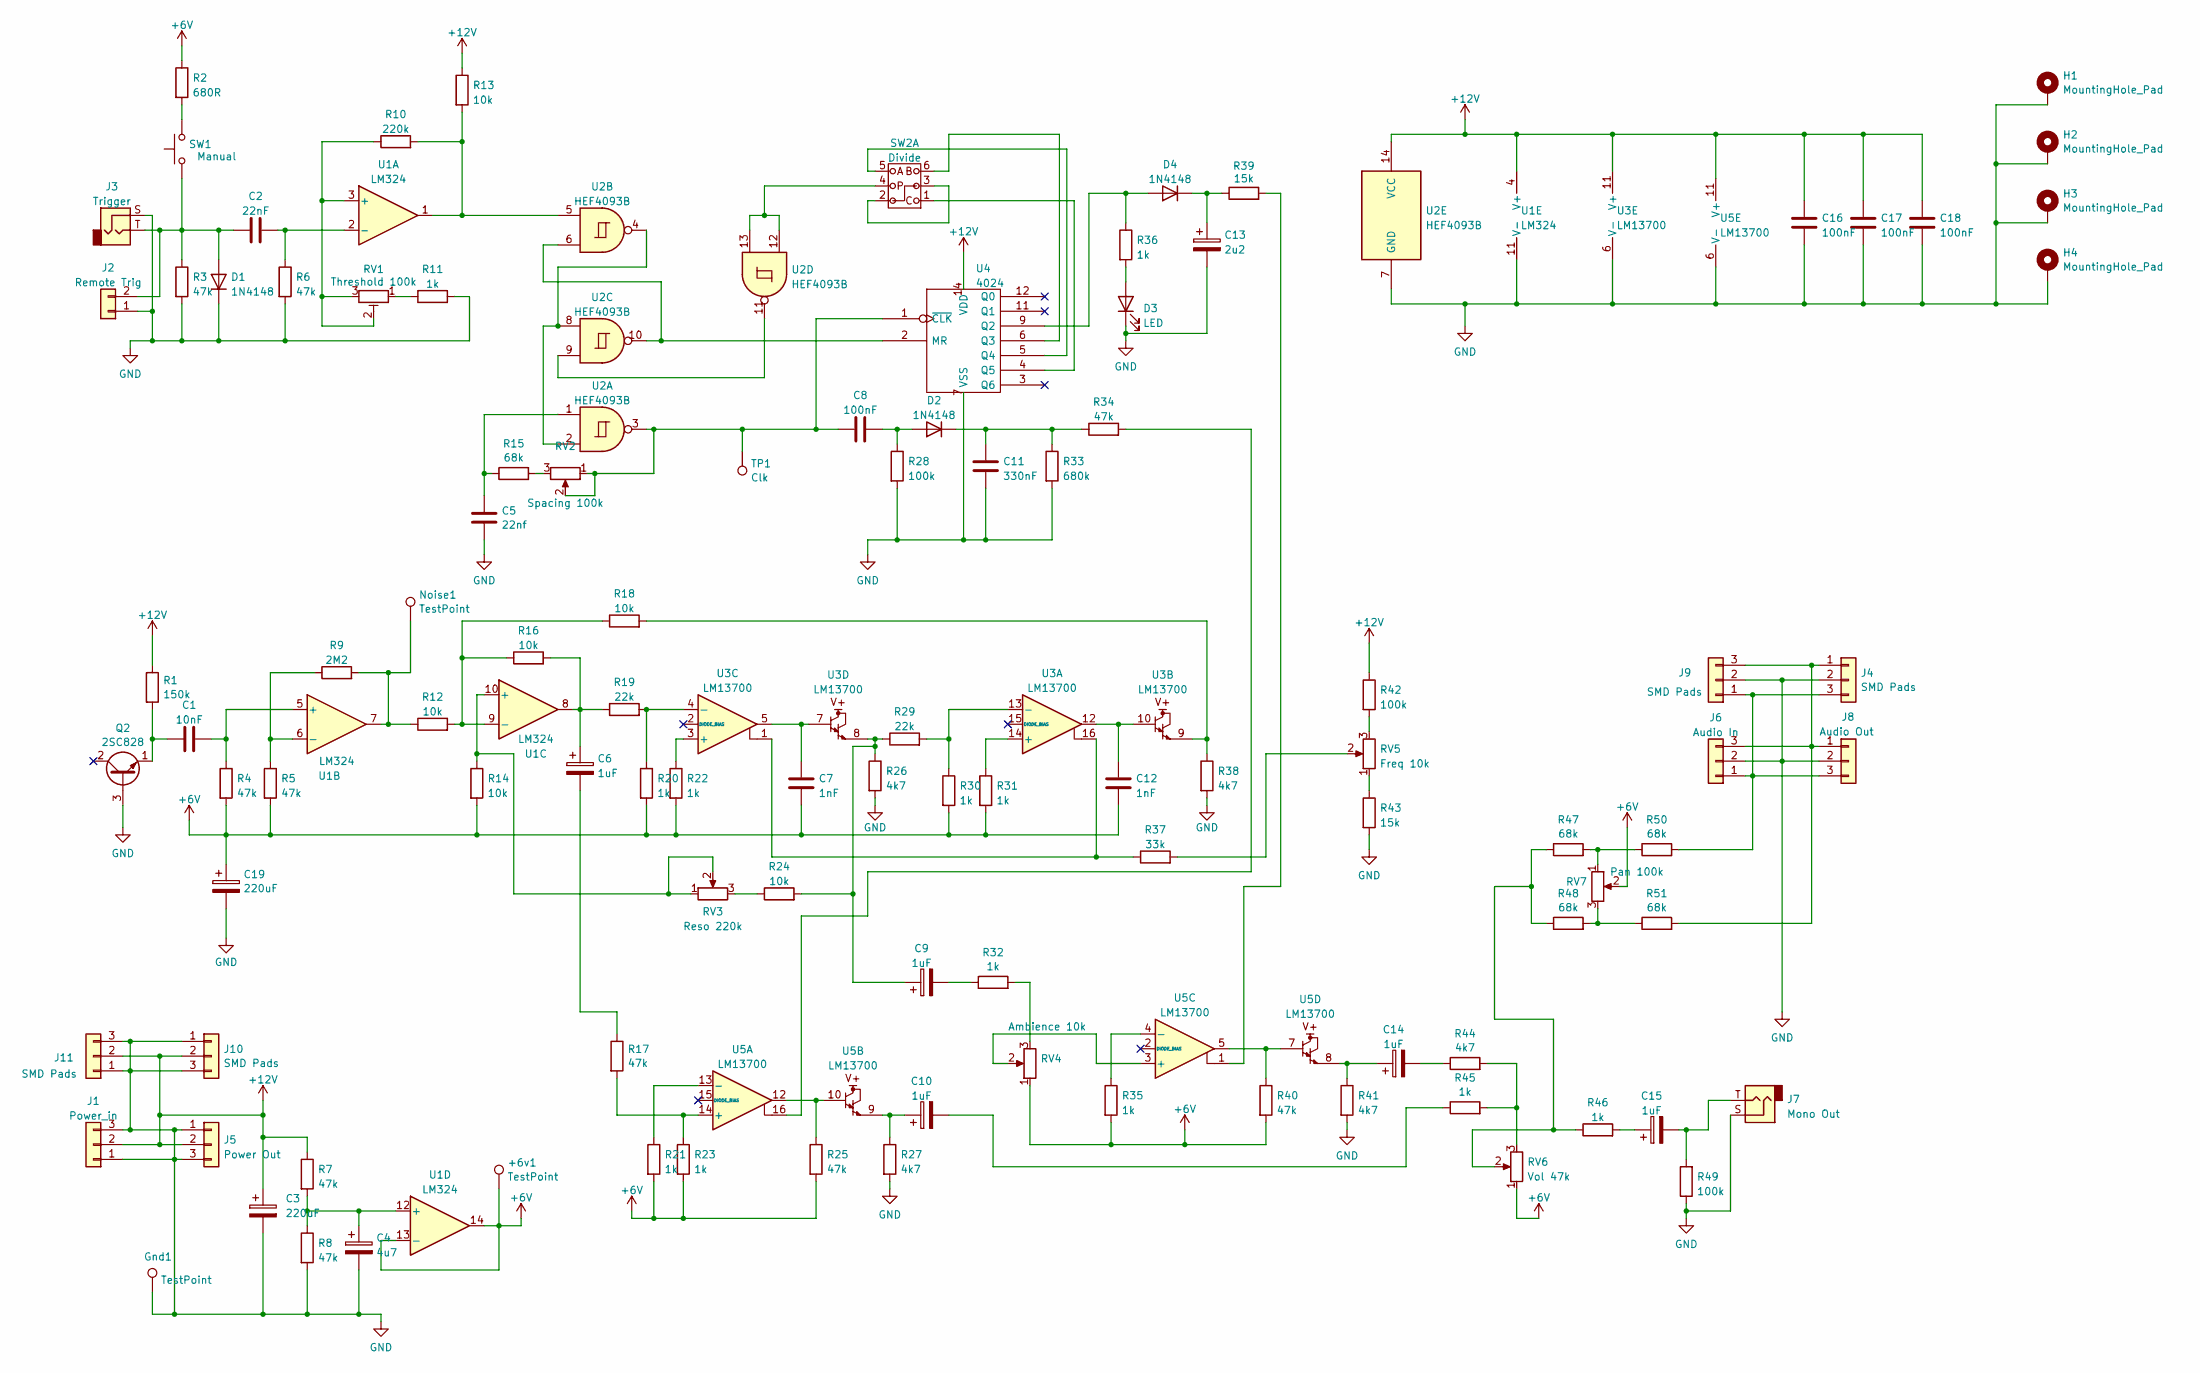
[picture p13: schematic Synclap.kicad_sch]

Parts:
+6v1: TestPoint; TestPoint_THTPad_D1.5mm_Drill0.7mm
C1: 10nF; C_Disc_D4.3mm_W1.9mm_P5.00mm
C2: 22nF; C_Disc_D4.3mm_W1.9mm_P5.00mm
C3: 220uF; CP_Radial_D8.0mm_P3.50mm
C4: 4u7; CP_Radial_D4.0mm_P1.50mm
C5: 22nf; C_Disc_D4.3mm_W1.9mm_P5.00mm
C6, C9, C10, C14, C15: 1uF; CP_Radial_D4.0mm_P1.50mm
C7, C12: 1nF; C_Disc_D4.3mm_W1.9mm_P5.00mm
C8: 100nF; C_Disc_D4.3mm_W1.9mm_P5.00mm
C11: 330nF; C_Disc_D4.7mm_W2.5mm_P5.00mm
C13: 2u2; CP_Radial_D4.0mm_P1.50mm
C16, C17, C18: 100nF; C_0805_2012Metric
C19: 220uF; CP_Radial_D6.3mm_P2.50mm
D1, D2, D4: 1N4148; D_MiniMELF
D3: LED; LED_D3.0mm
Gnd1: TestPoint; TestPoint_THTPad_D1.5mm_Drill0.7mm
H1, H2, H3, H4: MountingHole_Pad; MountingHole_3.2mm_M3_DIN965_Pad
J1: Power_in; PinHeader_1x03_P2.54mm_Horizontal
J2: Remote Trig; PinHeader_1x02_P2.54mm_Vertical
J3: Trigger; Jack_3.5mm_QingPu_WQP-PJ398SM_Vertical_CircularHoles
J4, J9, J10, J11: SMD Pads; Bus Connector
J5: Power Out; PinHeader_1x03_P2.54mm_Horizontal
J6: Audio In; PinHeader_1x03_P2.54mm_Horizontal
J7: Mono Out; Jack_3.5mm_QingPu_WQP-PJ398SM_Vertical_CircularHoles
J8: Audio Out; PinHeader_1x03_P2.54mm_Horizontal
Noise1: TestPoint; TestPoint_THTPad_D1.5mm_Drill0.7mm
Q2: 2SC828; TO-92_Inline
R1: 150k; R_1206_3216Metric
R2: 680R; R_1206_3216Metric
R3, R4, R5, R6, R7, R8, R17, R25, R34, R40: 47k; R_1206_3216Metric
R9: 2M2; R_1206_3216Metric
R10: 220k; R_1206_3216Metric
R11, R20, R21, R22, R23, R30, R31, R32, R35, R36, R45, R46: 1k; R_1206_3216Metric
R12, R13, R14, R16, R18, R24: 10k; R_1206_3216Metric
R15, R47, R48, R50, R51: 68k; R_1206_3216Metric
R19, R29: 22k; R_1206_3216Metric
R26, R27, R38, R41, R44: 4k7; R_1206_3216Metric
R28, R42, R49: 100k; R_1206_3216Metric
R33: 680k; R_1206_3216Metric
R37: 33k; R_1206_3216Metric
R39, R43: 15k; R_1206_3216Metric
RV1: Threshold 100k; Potentiometer_Piher_PT-6-V_Vertical
RV2: Spacing 100k; Potentiometer_Alps_RK09K_Single_Vertical
RV3: Reso 220k; Potentiometer_Alps_RK09K_Single_Vertical
RV4: Ambience 10k; Potentiometer_Alps_RK09K_Single_Vertical
RV5: Freq 10k; Potentiometer_Alps_RK09K_Single_Vertical
RV6: Vol 47k; Potentiometer_Alps_RK09K_Single_Vertical
RV7: Pan 100k; Potentiometer_Alps_RK09K_Single_Vertical
SW1: Manual; SW_PUSH_6mm
SW2: Divide; 1P3WSW
TP1: Clk; TestPoint_THTPad_D1.5mm_Drill0.7mm
U1: LM324; SO-14_3.9x8.65mm_P1.27mm
U2: HEF4093B; SO-14_3.9x8.65mm_P1.27mm
U3, U5: LM13700; SO-16_3.9x9.9mm_P1.27mm
U4: 4024; SO-14_3.9x8.65mm_P1.27mm

Connections:
+6V: +6v1.1, C7.2, C12.2, C19.1, R2.1, R4.2, R5.2, R14.2, R20.2, R21.2, R22.2, R23.2, R25.2, R30.2, R31.2, R35.2, R40.2, RV4.1, RV6.1, RV7.2, U1.13 (-), U1.14; also elsewhere on the board
+12V: C3.1, C16.1, C17.1, C18.1, J1.2, J5.2, J10.2, J11.2, R1.1, R7.1, R13.1, R42.1, U1.4 (V+), U2.14 (VCC), U3.11 (V+), U4.14 (VDD), U5.11 (V+)
GND: C3.2, C4.2, C5.2, C11.2, C13.2, C16.2, C17.2, C18.2, C19.2, D1.1 (K), D3.1 (K), Gnd1.1, H1.1, H2.1, H3.1, H4.1, J1.1, J1.3, J2.1, J3.S, J4.2, J5.1, J5.3, J6.2, J7.S, J8.2, J9.2, J10.1, J10.3, J11.1, J11.3, Q2.3 (B), R3.2, R6.2, R8.2, R11.2, R26.2, R27.2, R28.2, R33.2, R38.2, R41.2, R43.2, R49.1, RV2.MP, RV3.MP, RV4.MP, RV5.MP, RV6.MP, RV7.MP, U1.11 (V-), U2.7 (GND), U3.6 (V-), U4.7 (VSS), U5.6 (V-); also elsewhere on the board
unnamed: C5.1, R15.1, U2.1
unnamed: C6.1, R16.2, R19.1, U1.8
unnamed: C6.2, R17.1
unnamed: C7.1, U3.5, U3.7
unnamed: C9.1, R24.2, R26.1, R29.1, U3.8
unnamed: C9.2, R32.1
unnamed: C10.1, R27.1, U5.9
unnamed: C10.2, R45.1
unnamed: C12.1, U3.10, U3.12
unnamed: C14.1, R41.1, U5.8
unnamed: C14.2, R44.1
unnamed: C15.1, R46.2
unnamed: C15.2, J7.T, R49.2
unnamed: C2.1, D1.2 (A), J2.2, J3.T, R3.1, SW1.1
unnamed: C8.2, D2.2 (A), R28.1
unnamed: C11.1, D2.1 (K), R33.1, R34.1
unnamed: D3.2 (A), R36.2
unnamed: D4.2 (A), R36.1, U4.9 (Q2)
unnamed: C13.1, D4.1 (K), R39.1
unnamed: J4.1, J6.3, J8.1, J9.3, R51.2
unnamed: J4.3, J6.1, J8.3, J9.1, R50.2
unnamed 24: Noise1.1, R9.2, R12.1, U1.7; also elsewhere on the board
unnamed: C1.1, Q2.1 (E), R1.2
unnamed: R2.2, SW1.2
unnamed: R10.2, R13.2, U1.1, U2.5
unnamed: R11.1, RV1.1
unnamed: R15.2, RV2.3
unnamed: R18.2, R38.1, U3.9
unnamed: R24.1, RV3.3
unnamed: R25.1, U5.10, U5.12
unnamed: R32.2, RV4.3
unnamed: R34.2, U5.16
unnamed: R37.1, U3.1, U3.16
unnamed: R37.2, RV5.2
unnamed: R39.2, U5.1
unnamed: R40.1, U5.5, U5.7
unnamed: R42.2, RV5.3
unnamed: R43.1, RV5.1
unnamed: R44.2, R45.2, RV6.3
unnamed: R46.1, R47.1, R48.1, RV6.2
unnamed: R47.2, R50.1, RV7.1
unnamed: R48.2, R51.1, RV7.3
unnamed: SW2.2, SW2.3
unnamed: SW2.4, U2.12, U2.13
unnamed: R10.1, RV1.2, RV1.3, U1.3 (+)
unnamed: C2.2, R6.1, U1.2 (-)
unnamed: C1.2, R4.1, U1.5 (+)
unnamed: R5.1, R9.1, U1.6 (-)
unnamed: R14.1, RV3.1, RV3.2, U1.10 (+)
unnamed: R12.2, R16.1, R18.1, U1.9 (-)
unnamed: C4.1, R7.2, R8.1, U1.12 (+)
unnamed: U2.2, U2.4, U2.8
unnamed: U2.9, U2.11
unnamed: R31.1, U3.14 (+)
unnamed: R29.2, R30.1, U3.13 (-)
unnamed: R22.1, U3.3 (+)
unnamed: R19.2, R20.1, U3.4 (-)
unnamed: U2.6, U2.10, U4.2 (MR)
unnamed: SW2.6, U4.6 (Q3)
unnamed: SW2.5, U4.5 (Q4)
unnamed: SW2.1, U4.4 (Q5)
unnamed 64: C8.1, RV2.1, RV2.2, TP1.1, U2.3, U4.1 (~CLK); also elsewhere on the board
unnamed: R17.2, R23.1, U5.14 (+)
unnamed: R21.1, U5.13 (-)
unnamed: RV4.2, U5.3 (+)
unnamed: R35.1, U5.4 (-)

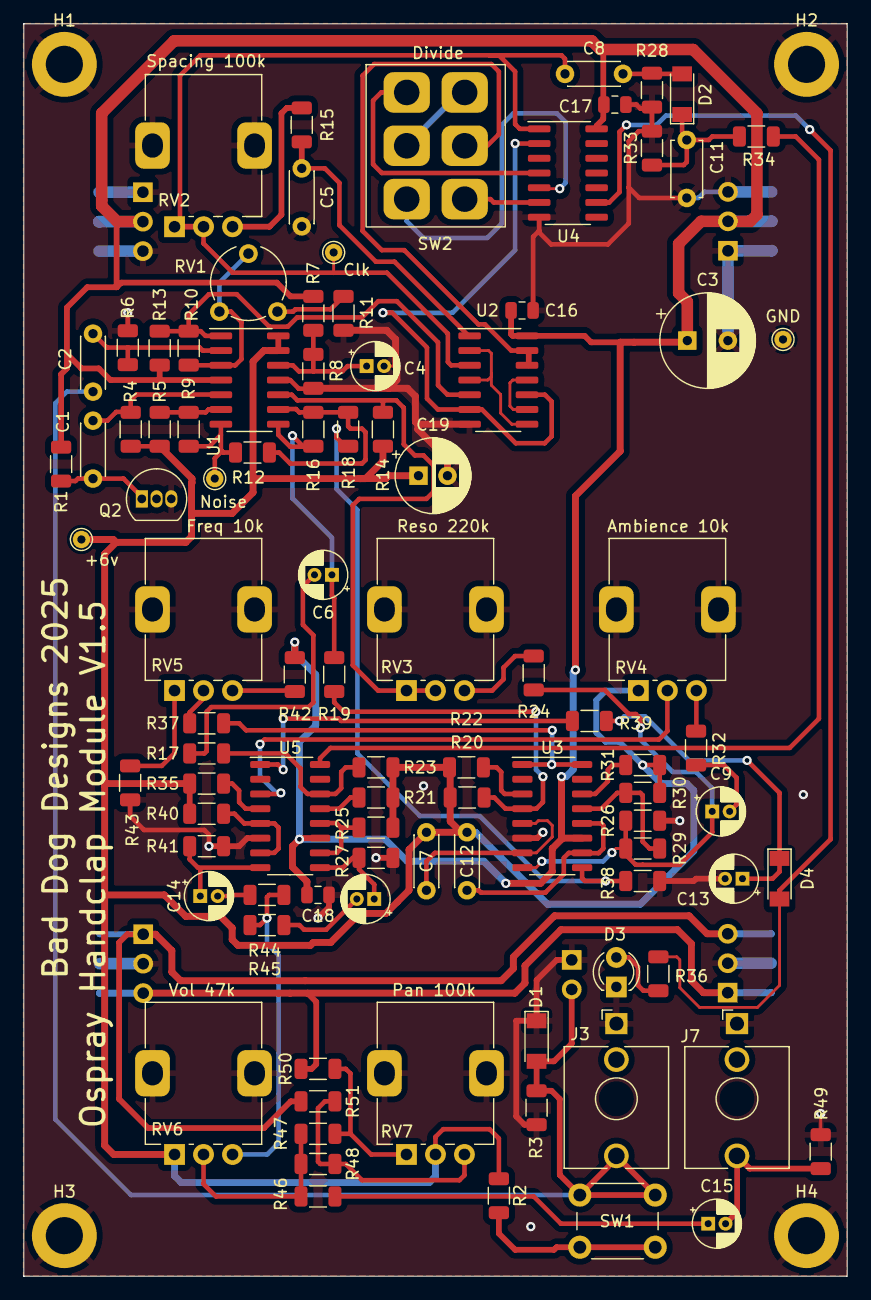
[picture p14: board Synclap.kicad_pcb from above]

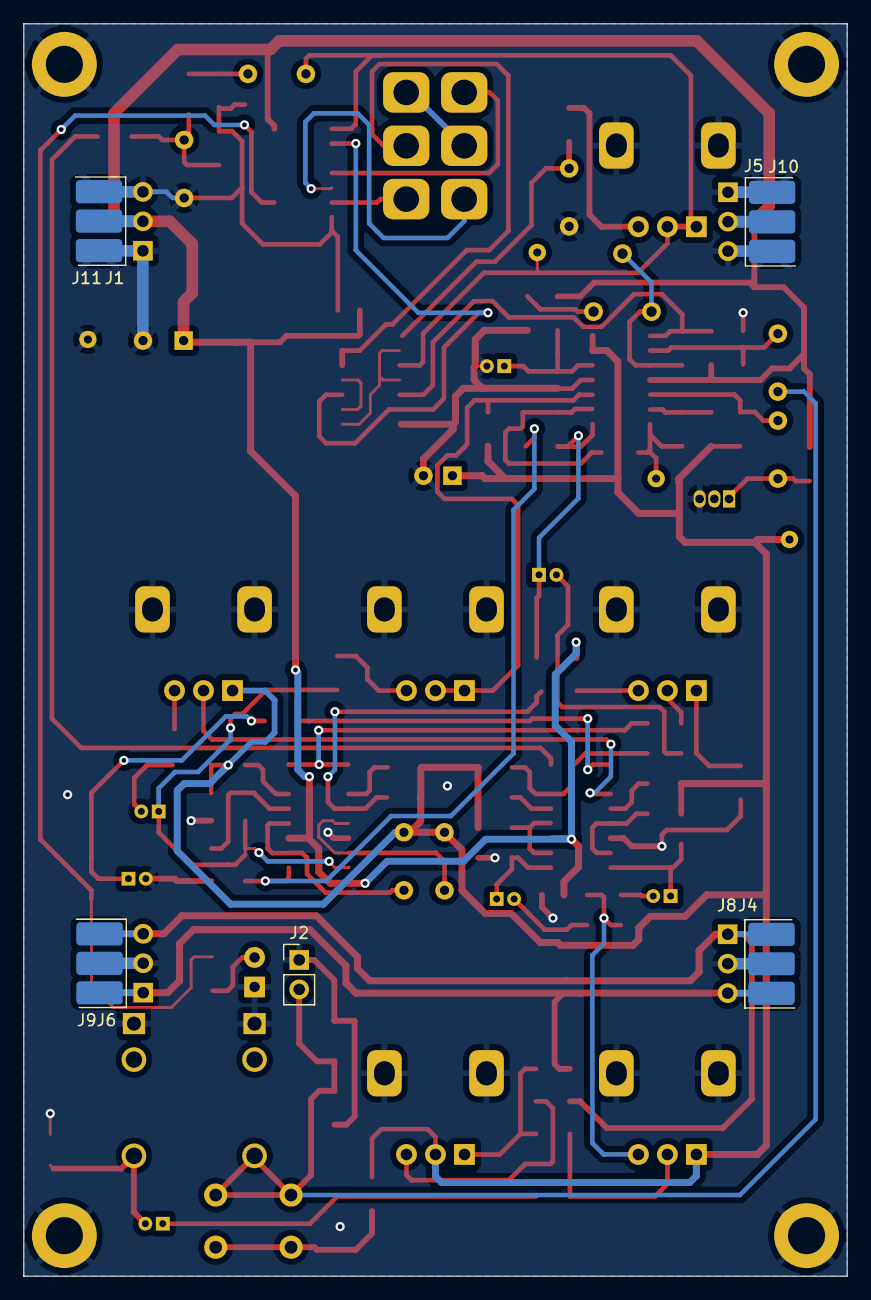
[picture p15: board Synclap.kicad_pcb from below]

Board: 2 copper layers, 71.0 x 108.0 mm, 108 parts (9 on the bottom side), 69 nets.

Other parts of the board:
+6v: TestPoint; TestPoint_THTPad_D1.5mm_Drill0.7mm
Clk: Clk; TestPoint_THTPad_D1.5mm_Drill0.7mm
GND: TestPoint; TestPoint_THTPad_D1.5mm_Drill0.7mm
Noise: TestPoint; TestPoint_THTPad_D1.5mm_Drill0.7mm

Their connections:
+6V: +6v.1; also elsewhere on the board
GND: GND.1; also elsewhere on the board
unnamed 24: Noise.1; also elsewhere on the board
unnamed 64: Clk.1; also elsewhere on the board
