Bad-Dog-Designs/Ospray-8/(commit log)

2026-06-27 Arduino Code for Midi input
2026-06-27 Synclap KiCad project files and production files
    [Synclap-B_Cu.gbr, Synclap-B_Mask.gbr, Synclap-B_Paste.gbr, Synclap-B_Silkscreen.gbr, Synclap-Edge_Cuts.gbr, Synclap-F_Cu.gbr, Synclap-F_Mask.gbr, Synclap-F_Paste.gbr]
2026-06-27 Midi interface / Line output Amp KiCad Project
    [Synmidi.kicad_pcb, Synmidi.kicad_sch, Synmidi_Main.kicad_pcb, Synmidi_Midi.kicad_pcb, bom.csv, designators.csv, positions.csv]
2026-06-27 Syntom KiCad project files
    [Syntom.kicad_pcb, Syntom.kicad_sch, bom.csv, designators.csv, positions.csv]
2026-06-27 Synbal KiCad Project files
    [Synbal-B_Cu.gbr, Synbal-B_Mask.gbr, Synbal-B_Paste.gbr, Synbal-B_Silkscreen.gbr, Synbal-Edge_Cuts.gbr, Synbal-F_Cu.gbr, Synbal-F_Mask.gbr, Synbal-F_Paste.gbr]
